ruffsl/ROBO/Documentation/Pictures/Design Photos/UnicyclePhoto3.JPG

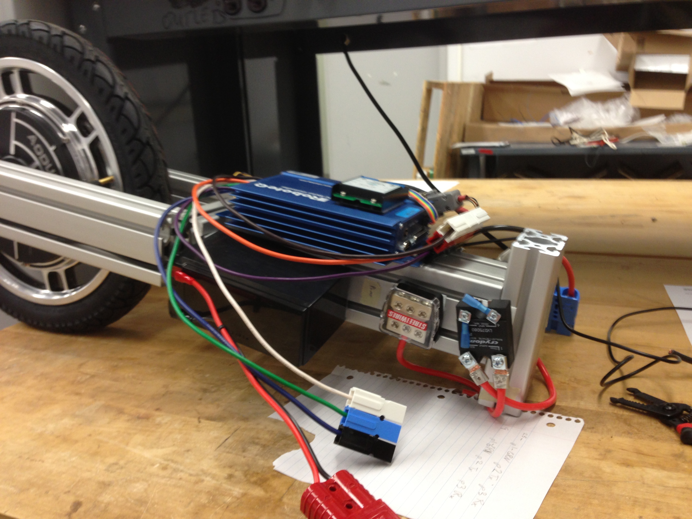
Documentation/Pictures/Design Photos/UnicyclePhoto3.JPG
