ruffsl/ROBO/Documentation/Pictures/Design Photos/UnicyclePhoto1.JPG

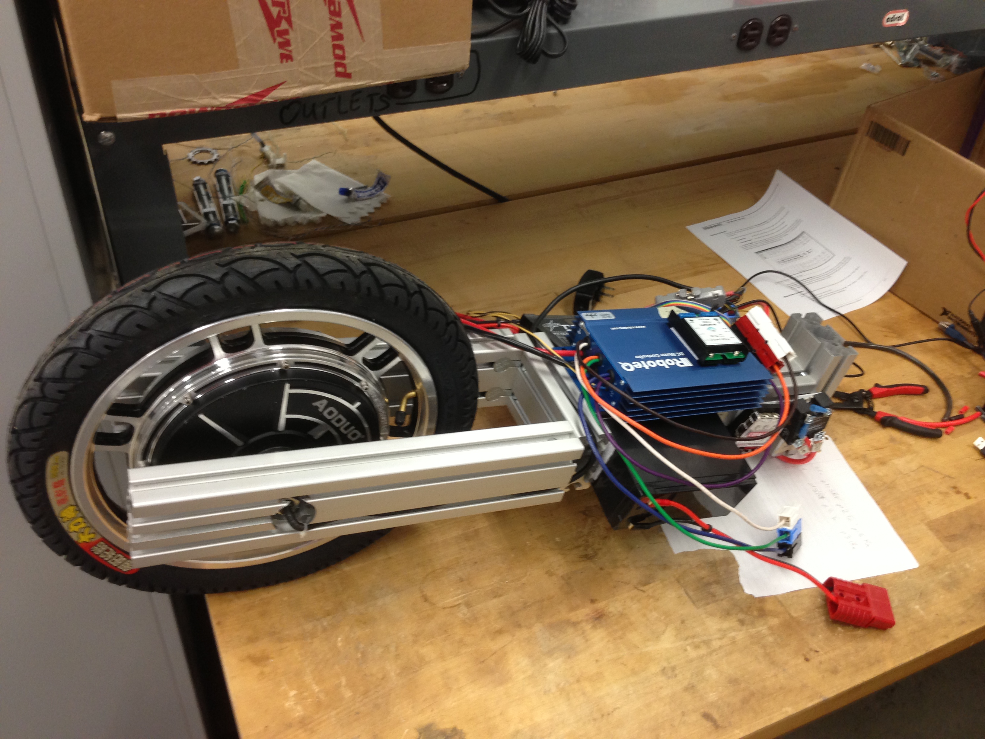
Documentation/Pictures/Design Photos/UnicyclePhoto1.JPG
