ruffsl/ROBO/Documentation/Power Points/Overview.pptx

## Slide 2

System Modeling
Part acquisition
Prototype Construction
Control Debugging
Documentation
Community Publication

## System Modeling Part acquisition

System and Model Research
Part listings and specking
Computer Simulation
System Characterization
Control Testing
Part Ordering and Inventory

## Prototype Construction Control Debugging

Sensor Feedback Development
Motor Control Hookup
Frame Construction
Transition to Mobile Power
Control deployment
System Testing

## Documentation Community Publication

Fine Tuning Overlap
Release Project Cleanup
Collect Resources
Tutorial and Instructions
Demonstration
Community Publication
