ruffsl/ROBO/Documentation/Power Points/Robotics Design.pptx

## Robotics Design Team G Robotic Unicycle

Spencer Carver, Ander Solorzano,
Kevin Collins, Ruffin White-Magner

## Parts


- Real-time Platform
  - NI cRIO
- Hub-motors
  - Golden Motors
- Motor Controllers
  - RoboteQ
- IMU
  - Microstrain
- Battery
  - Sealed Lead Acid

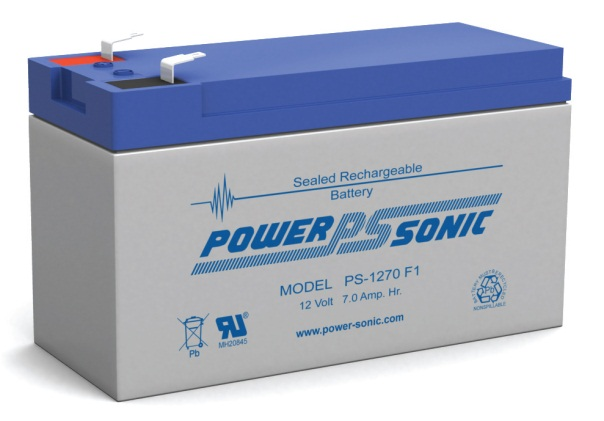
[picture p67: figure]

## Modeling

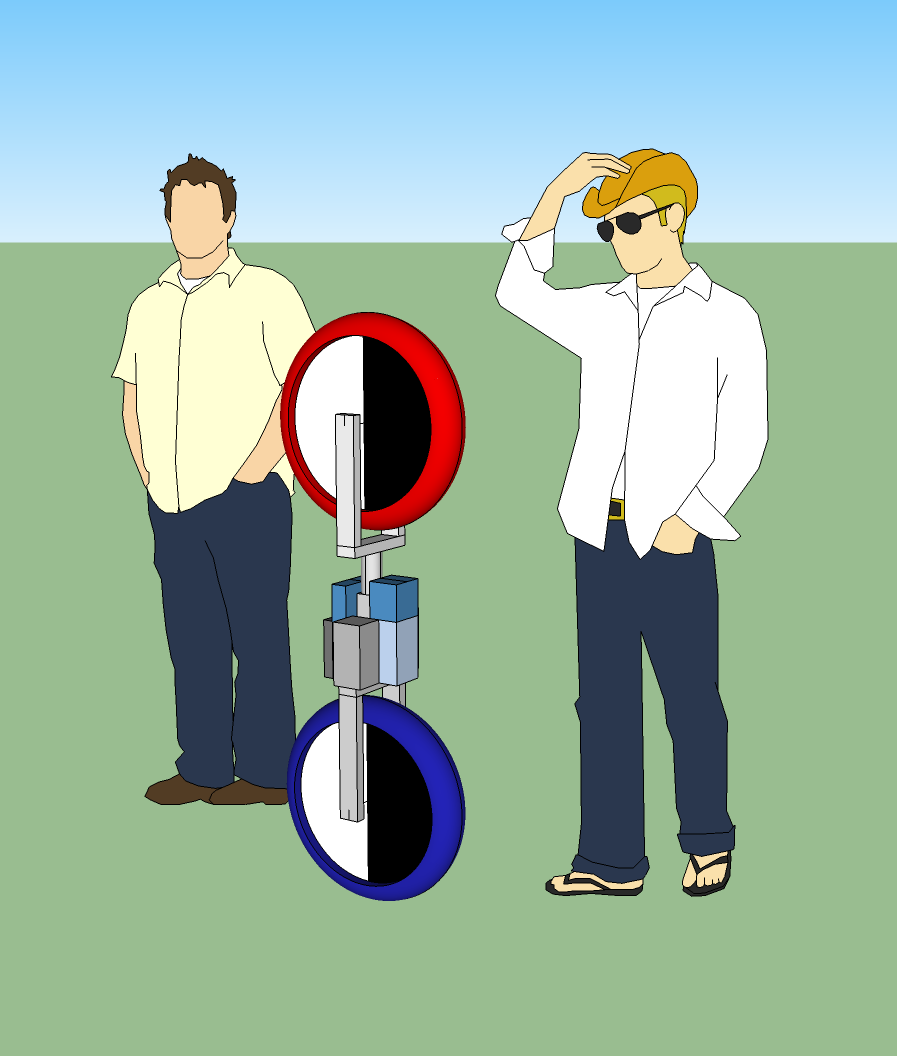
[picture p68: figure]
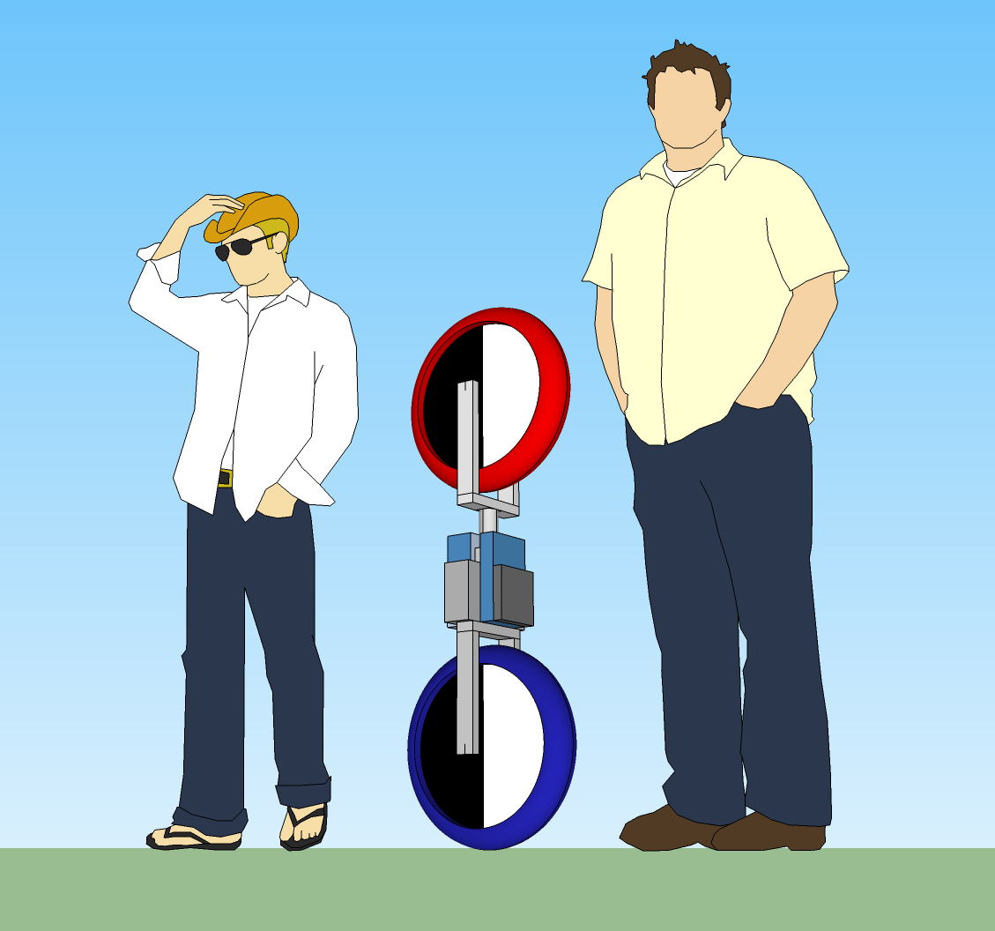
[picture p69: figure]

## Simulation

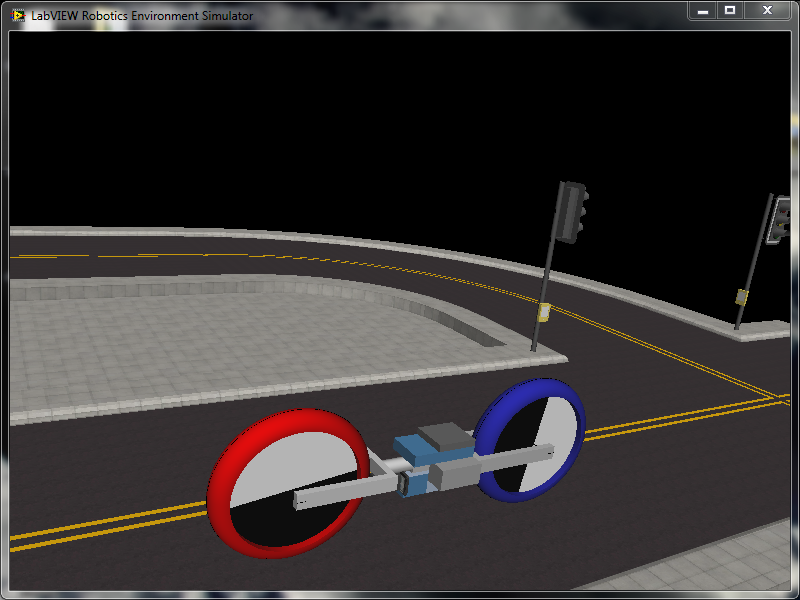
[picture p70: figure]
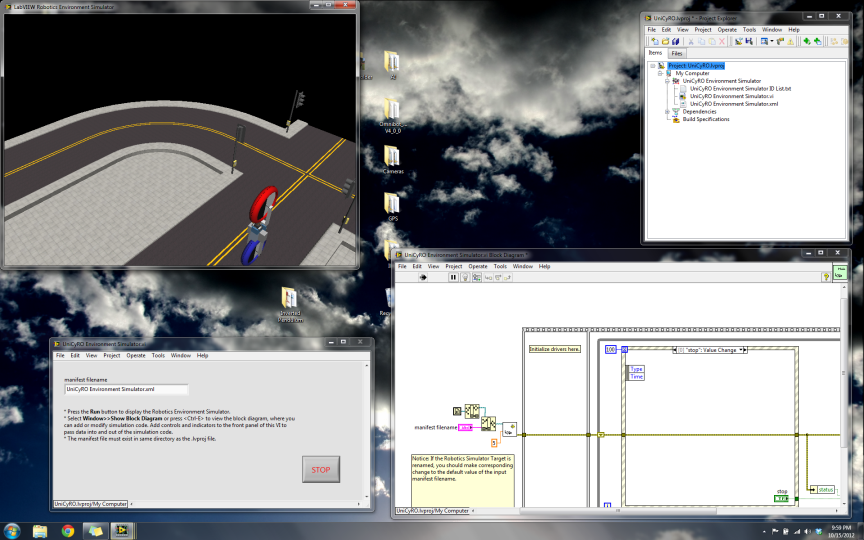
[picture p71: figure]
