ruffsl/ROBO/Documentation/Online Docs/Final Report - Spring Quarter/Action Plan.docx

Ruffin:

write timeline

NI student design submission

clean repo

Kevin:

wiring diagram

finish parameter spreadsheet

add stuff to repo

Ander:

start working on powerpoint - we’ll get together and finish up sunday night.

Spencer

decision matrices

testing plan

start exporting things to the binder

FSM overall “block diagram” (they say every project should have some sort of block diagram)
