ruffsl/ROBO/Documentation/Online Docs/Final Report - Spring Quarter/Final Presentation.pptx

## Self Balancing Unicycle

## Project Overview

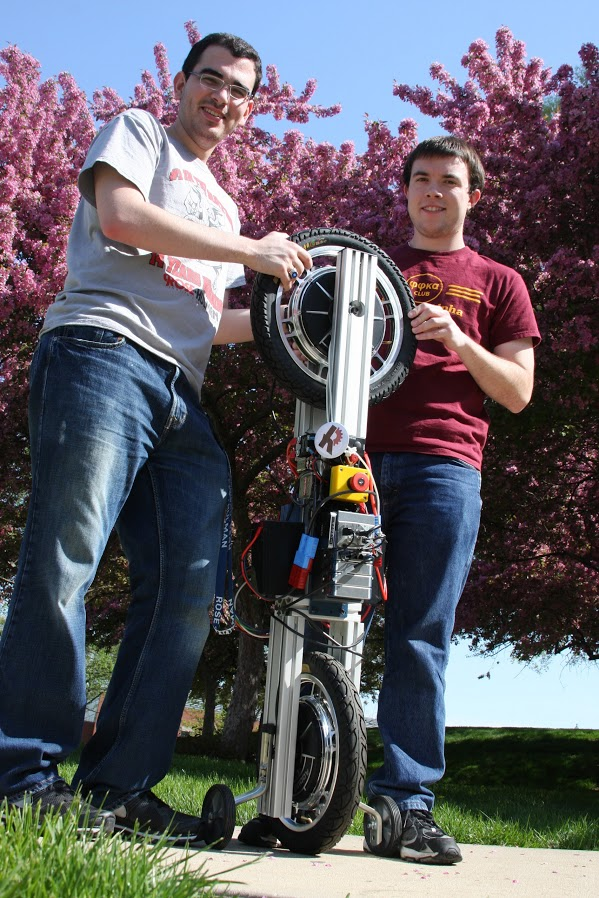
[picture p72: figure]

## System Description


## System Modeling

## Technical Specifications

pic of cRIO, motor controller

## Controls

## Unforeseen Challenges

## Testing Plan

## Suggestions for Improvement
