ruffsl/ROBO/Documentation/Power Points/Design Reviews/Speech Notes/Presentations/Final Presentation.pptx

## Self-Balancing Unicycle

Client: Andy Chang (National Instruments)
Supervisor: Dr. Robert Throne
Leader: Kevin Collins
Members: Spencer Carver
Ander Solorzano
Ruffin White-Magner

Team
G

Notes: Kevin

## Slide 2

Project Overview

Build a self-balancing robotic unicycle for National Instruments (NI), using NI components where possible


Notes: Kevin – 30 sec

We have been asked by national instruments to design and build a self balancing unicycle robot to showcase NI’s newest robotics toolkit.

National Instruments has developed a full solution to solving challenging controls problems with real time components, and this project is meant to show how a challenging controls problem can be solved using their components.

Our task is to develop a self balancing, autonomous unicycle style robot that can withstand disturbances such as light pushing. It does not have to navigate to a specific point or move at all, it only needs to balance independantly.

## Slide 3

Project Plan - Overview

Several Aspects to the Project:

Robotics Environment Simulator
Physical Construction
Mathematical Modeling
Electrical Wiring
Controls

Notes: Kevin – 30 sec

## Slide 4

Project Plan – Planning Flow Chart


Notes: Kevin – 30 seconds

Here you can see our project plan. The green line represents our current position in the plan, the checkboxes representing what has been accomplished. The fall has been and will continue to be primarily laying the groundwork for our project. We would like to have all of our components and make sure that we understand how they work and how to use them effectively. Then next quarter, we will be able to quickly and efficiently develop a control algorithm and build a physical model that will hopefully result in a working prototype by the end of the quarter. Then spring quarter is left entirely for debugging and final documentation.

## Slide 5

Project Construction - Mechanical


Notes: Kevin – 30 seconds

## Slide 6

Project Construction - Electrical

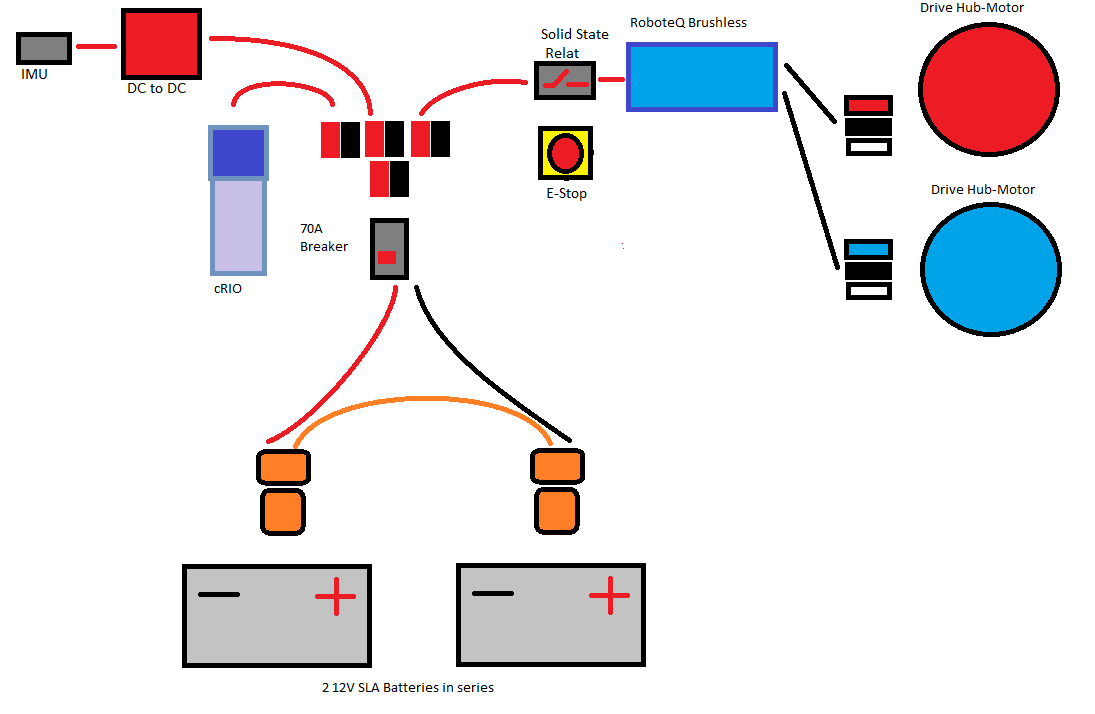
[picture p80: figure]

Notes: Ruffin – 30 sec
Labview Robotics Simulation Builder
With actuator and sensors
Build levels of complexity

## Slide 7

Project Software

Notes: Kevin

## Slide 8

Mathematical Modeling


Notes: Kevin – 30 seconds

## Slide 9

Control Strategies

Non-linear problem → Linearize → Use state variable description

Discrete time state variable feedback system


State Variable Equations

x(k+1)=G∗x(k)+H∗u(k)

y(k)=C∗x(k)+D∗u(k)

x(k) = state vector
u(k) = input vector to the plant
y(k) = output vector from the plant
G,H,C,D matrices are constant
K = feedback gain matrix

Notes: Ander – 2 min

## Slide 10

Control Strategies

Non-linear problem → Linearize → Use state variable description

Discrete time state variable feedback system

State Variable Equations

x(k+1)=G∗x(k)+H∗u(k)

y(k)=C∗x(k)+D∗u(k)

x(k) = state vector
u(k) = input vector to the plant
y(k) = output vector from the plant
G,H,C,D matrices are constant
K = feedback gain matrix

Notes: Ander – 2 min

## Slide 11

Control Strategies

Non-linear problem → Linearize → Use state variable description

Discrete time state variable feedback system

State Variable Equations

x(k+1)=G∗x(k)+H∗u(k)

y(k)=C∗x(k)+D∗u(k)

x(k) = state vector
u(k) = input vector to the plant
y(k) = output vector from the plant
G,H,C,D matrices are constant
K = feedback gain matrix

Notes: Ander – 2 min

## Slide 12

Project Status

Goal | Percent Complete
Simulation in LabVIEW | 100%
Physical Prototype Constructed | 100%
Balances in One Dimension | 75%
Balances in Two Dimensions | 20%
Controller Designed | 100%
Mathematical Model Designed | 100%

Notes: Kevin

## Slide 13

Project Status

Demo

Notes: Kevin

## Slide 14

Recommendations

- Moment of Inertia Calculations
- Improved Safety Rig

Notes: Kevin

## Slide 15

Conclusion - Questions

Budget

Simulator

Wiring Diagram

System Modeling

Hours

Notes: Kevin

## Slide 16

Simulation

Return

Return


Notes: Ruffin
Labview Robotics Simulation Builder
With actuator and sensors
Build levels of complexity

## Slide 17

Determining Parts – Budget

Total Cost: $27,740

Notes: Spencer

## Slide 18

Determining Parts – Budget

Total Cost: $4,740

Return

Notes: Spencer

## Slide 19

Wiring Diagram

Return


Notes: Kevin

## Slide 20

System Modeling

Return

State Variables

State Equations

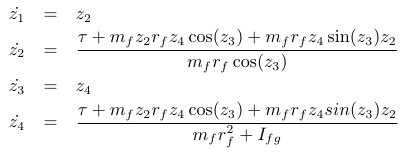
[picture p81: figure]
Screen Clipping

Notes: Kevin

## Slide 21

Hours

Total Team Hours - 784

Return

Notes: Kevin
