ruffsl/ROBO/Documentation/Design Documents/Ghant Chart - Sheet1.pdf

| | | | | | Fall Term | | | | | | | | | | Winter Term | | | | | | | | | | Spring Term
| | 1 | 2 | 3 | 4 | 5 | 6 | 7 | 8 | 9 | 10 | 1 | 2 | 3 | 4 | 5 | 6 | 7 | 8 | 9 | 10 | 1 | 2 | 3 | 4 | 5 | 6 | 7 | 8 | 9 | 10
Planning
Client Conference Calls
Project Planning
Install Software
Order Parts
Receive | Parts
Final Documentation
Modeling
Mechanical Modeling
Model Interaction with Sensors (software) Computer Programming & Simulation Assemble Mechanics
Assemble Electrical Hardware
Combine Components
Testing
Software Unit Testing
Integration Testing
Final Testing

# Ghant Chart
