ruffsl/ROBO/Documentation/Design Documents/Calculations/LaTeX/seniorDesignCalcs.pdf

# System Description and Modeling of a Self-Balancing Unicycle Robot

Kevin Collins
Rose-Hulman Institute of Technology Designed for National Instruments

May 12, 2013

1

## 1 Introduction

The purpose of this document is to provide a detailed explanation as to the derivation of the system model used for the self-balancing unicycle developed by Rose-Hulman’s Robotics Senior Design Team G for the client, National Instruments.

## 2 System Description

The Robot is composed of a chassis made of 40mm T-slotted aluminum extrusion. This type of frame works very well for our robot due to its modular nature. This means, however, that many of the parameters described in this document are non-static, in that it is very possible that they have changed. All of the calculations are as modular as possible so that any changes can be easily

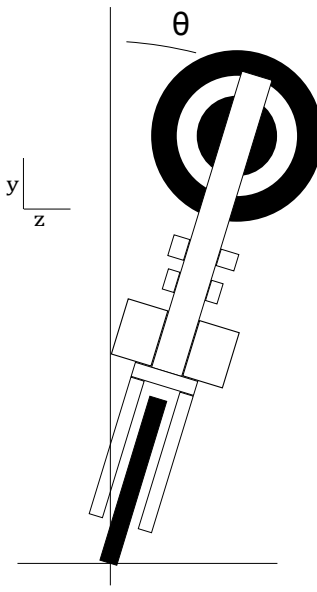
[picture p101: figure]
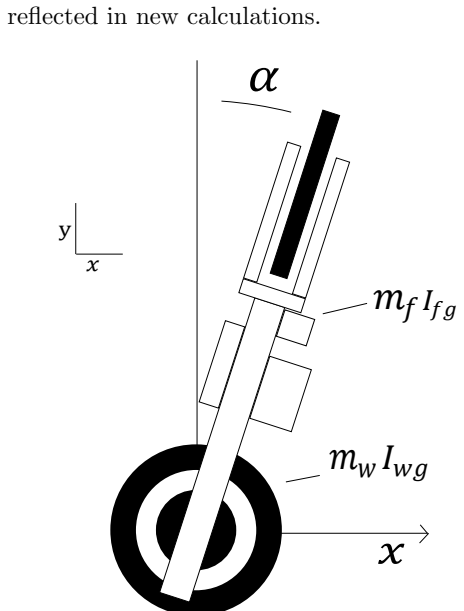
[picture p102: figure]
reflected in new calculations. 

Our robot must balance in two directions: about the z axis in the x-y plane, and about the x axis about the z-y plane. In both cases, the offset angle is measured from the inertial measurement unit located directly below the top wheel. In the first dimension (the x-y plane) the robot corrects itself by applying a torque to the lower wheel. In the second dimension (the z-y plane) the robot corrects itself by applying a torque to the upper wheel.

2

## 3 First Dimension

We start by looking at the general form of the Lagrangian equation. The Lagrangian is used in this application because of its modular nature compared to the conservation principle approach. If something with the model changes, the overall model can be easily updated.

L = T − V | (1)

In the Lagrangian, T is the kinetic energy associated with the system. The kinetic energy elements of our system include the rotational energy associated with the wheel spinning, the rotational energy associated with the frame spinning about the wheel, the translational energy associated with the wheel moving in the x direction, and the translational energy with the frame moving in the x direction relative to the movement of the wheel. These terms are shown below.

Translational energy, Wheel: 1
2

(mwx˙

2
)

Translational energy, Frame: 1 2mf ( ˙x

2 + 2 ˙xrfα˙ cos(α) + r

2
fα˙

2
)

Rotational energy, Wheel: 1
2
Iwgx˙

2
r

2
w

Rotational energy, Frame: 1
2

(If gα˙

2
)

The resulting expression for T is thus:

T =

1
2

(mwx˙

2

) + 1
2

mf ( ˙x

2 + 2 ˙xrfα˙ cos(α) +r

2
fα˙

2

) + 1
2
Iwgx˙

2
r

2
w
+

1
2

(If gα˙

2
) (2)

The V term in the Lagrangian equation is the potential energy of the system. In this case, this is simply the weight of the frame.

V = mf grf cos(α) | (3)

Combining the two terms to form the Lagrangian results in:

L =

1
2

(mwx˙

2

)+1
2

mf ( ˙x

2+2 ˙xrfα˙ cos(α)+r

2
fα˙

2

)+1
2
Iwgx˙

2
r

2
w
+

1
2

(If gα˙

2
)−mf grf cos(α)

(4)

The next step is to take the following derivatives and relate them to the virtual work of the system, in this case τ .

d

dt
∂L
∂α˙
−
∂L

∂α
= τ | (5)

3

The resulting derivative and its expanded form are shown below:

mf rf (¨x cos(α) − α˙ sin(α) ˙x) + mf r

2
fα¨ + If gα¨
− mfxr˙ fα˙ cos(α) = τ (6)

xm¨ f rf cos(α) − mf rfα˙ sin(α) ˙x + mf r

2
fα¨ + If gα¨ − mfxr˙ fα˙ cos(α) = τ (7)

This model is then put into state-space form, the state variables being:

z1 = x
z2 = ˙x
z3 = α
z4 = ˙α
(8)

The state model is then as follows:

z˙1 | = z2
z˙2 | =

τ + mf z2rf z4 cos(z3) + mf rf z4 sin(z3)z2 mf rf cos(z3)
z˙3 | = z4
z˙4 | =

τ + mf z2rf z4 cos(z3) + mf rf z4sin(z3)z2 mf r

2
f + If g
(9)

4

## 4 Second Dimension

The second dimension is calculated in a similar manner as the first. This time, T is computed from the rotation energy of the top wheel, the translational energy of the top wheel, the rotational energy of the frame, and the translational energy of the frame.

T =

1
2

mwx˙

2 +

1
2

If

˙θ
2 + τθ +

1
2

mf r

2
f

˙θ
2
(10)

V is then the gravitational potential energy of the frame, and the gravitational potential energy of the wheel.

V = mf gL1 cos(θ) + mwg(L1 + L2) cos(θ) | (11)

The Lagrangian is:
L = T − V | (12)

Which, when evaluated with the above equations, results in the following:

L =

1
2

mwx˙

2+

1
2

If

˙θ
2+τθ+

1
2

mf r

2
f

˙θ
2−mf gL1 cos(θ)−mwg(L1+L2) cos(θ) (13)

Taking the partial derivatives results in the following equations:

∂L
∂θ = mf gL1 cos(θ)mwg(L1 + L2) cos(θ) + τ | (14)

∂L
∂ ˙θ

= If

˙θ + mf r
2
f
˙θ | (15)

d

dt
∂L
∂ ˙θ
= If

¨θ + mf r
2
f
¨θ | (16)

d

dt
∂L
∂ ˙θ
−

∂L
∂ ˙θ

= If

¨θ + mf r
2
f

¨θ − mf gL1 cos(θ)mwg(L1 + L2) cos(θ) + τ (17)

which is equal to the virtual work of the system. This equation can then be put into state space form as shown in the first dimension.

5

## 5 Moment of Inertia Calculations

For our system, the moment of inertia was was calculated by combining the moment of inertia of the following elements:

- Top Components - top wheel, top fork, top junction
- Middle Components - IMU, e-stop power1, power2, dc-dc converter, relay, breaker, controller, battery1, battery2, cRIO, center column
- Lower Components - bottom wheel, bottom fork1, bottom fork2, bottom junction

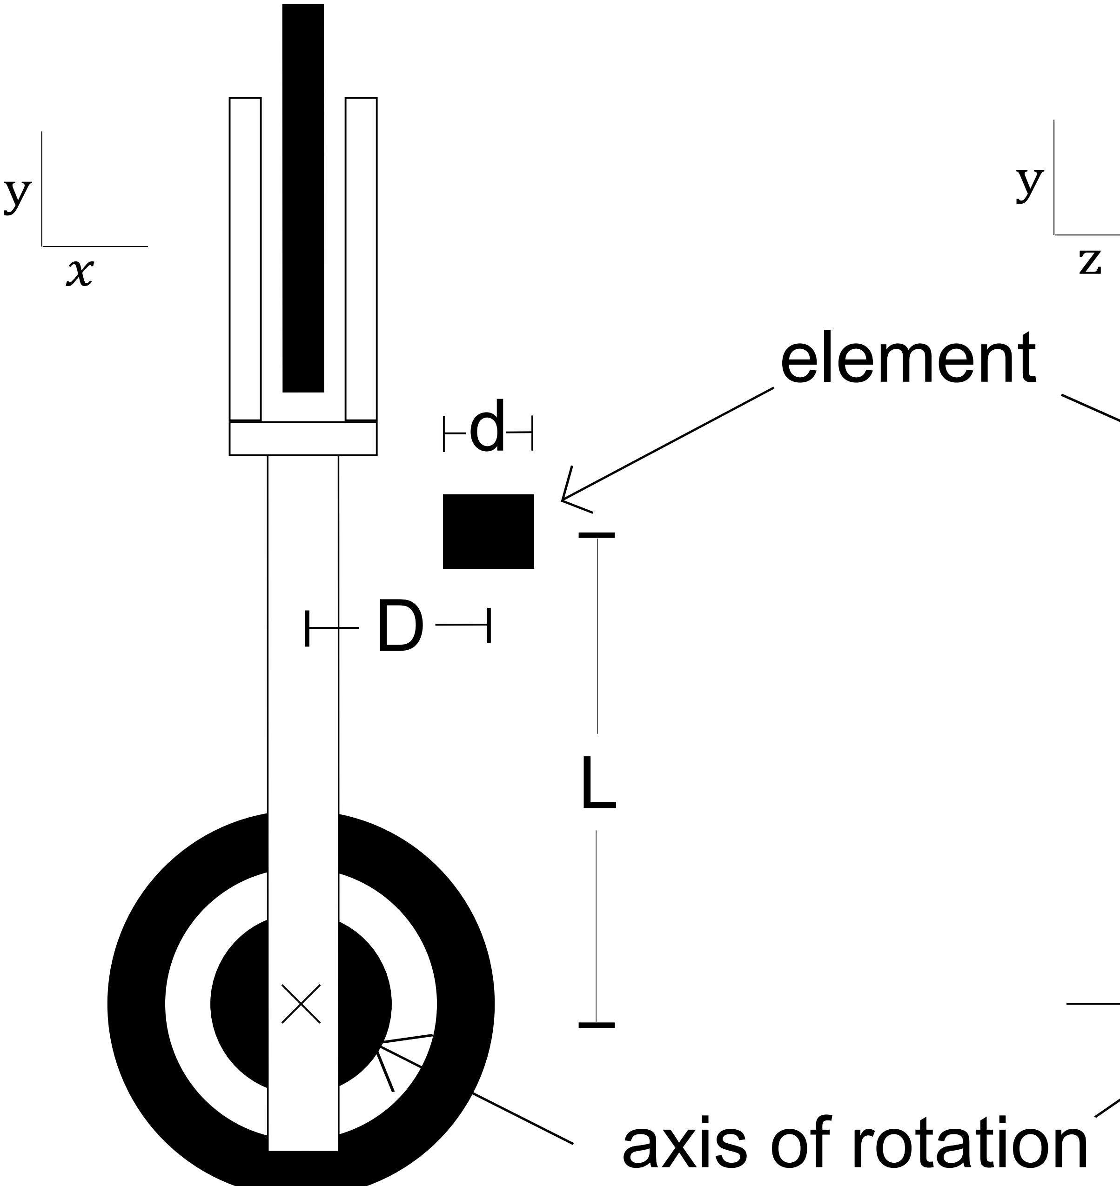
[picture p103: figure]
element; axis of rotation
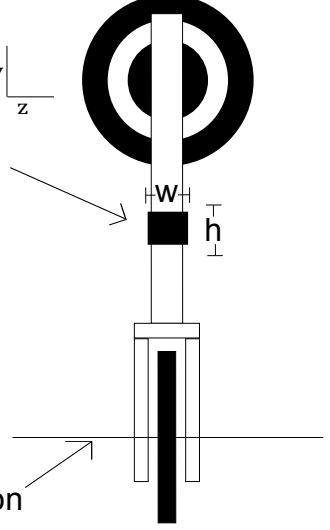
[picture p104: figure]

The equations for a moment of inertia of an object in 3d about an axis are represented by the following equations:

Ih =

1
12

m(w

2 + d

2
)

Iw =

1
12

m(h

2 + d

2
)

Id =

1
12

m(h

2 + w

2
)

(18)

In the system described in section 1, the first dimension has a rotation about the d axis. The equations above are valid if the elements are rotated about an axis that runs through the center of mass of the element. The axis of rotation

6

for most of our elements do not run through the center of mass, so to calculate this value, we use the parallel axis theorem. The parallel axis theorem can determine the moment of inertia about any axis given the moment of inertia about a parallel axis that passes through the center of gravity of the element, and the perpendicular distance between the two axes (r).

Iz = Icm + mr²
(19)

In the 3d case, r

2 has two vector components to it, resulting in an absolute distance from the axis of rotation. Many of our components are centered directly above the axis of rotation, so the third dimension is 0, but this is still accounted for in our calculation.

The rotation axis of the first dimension is about the axle of the lower motor. The rotation axis of the 2nd dimension is about the axis running along the length of the wheel where it contacts the ground.

All of the components on our robot were modeled as either rectangular prisms or solid cylinders.

For a solid rectangular prism, the equation for the moment of inertia about a given axis with

7

## 6 Suggestions for Improvement

As stated in the previous section, all of the components on our robot were modeled as either rectangular prisms or solid cylinders. This is an extreme simplification, especially in the case of the motors. If more work was to be done in modeling the system, I would suggest that a more accurate model of the wheels be determined first.

As far as the second dimension goes, these equations were not verified the same way that the first dimension was. The equations of motion were derived the same way they were for the first dimension, but they should be verified before deployed in a controller.

8
