ruffsl/ROBO/Documentation/Design Documents/bolts list.xlsx

 | in. | mm. | qty
relay | 0.19 | 4.826 | 2
power | 0.17 | 4.318 | 4
estop | 0.17 | 4.318 | 2
circuit breaker | 0.25 | 6.35 | 2
motor controller | 0.25 | 6.35 | 4
guard | 0 | 6 | 4
crio | - | 5.08 | 4
narrowest are 1.5 in away
