ruffsl/ROBO/Documentation/Design Documents/Calculations/values.xlsx

side rail (2 holes) | 1.624
side rail (4 holes) | 1.61
side rail chanel (4 holes) | 1.578
side rail chanel (2 holes) | 1.594
cRIO | 1.852
battery | 2.336
motor controller | 1.234
power splitter | 0.142
wheel | 7.645
imu | 0.024
center | 3.41 | 2.041
anchor bolts | 0.046
powerConverter | 0.104
relay switch | 0.124
muxer | 0.082
circuit breaker | 0.12
estop switch | 0.16
 | M | L | D | I
top wheel | 7.645
fork | 1.624
fork | 1.624
junction |  |  | #bolts | size
IMU | 0.024 |  | - | -
e-stop | 0.16 |  | 4 | 3
power | 0.142 |  | 2 | 3
power | 0.142 |  | 2 | 3
converter | 0.104 |  | - | -
relay | 0.124 |  | 2 | 3
breaker | 0.12 |  | 2 | 4
controller | 1.234 |  | 4 | 4
battery | 2.336 |  | - | -
battery | 2.336 |  | - | -
cRIO | 1.852
column |  |  | - | -
junction |  |  | - | -
fork | 1.624 |  | - | -
fork | 1.624 |  | - | -
bottom wheel | 7.645 |  | - | -
 | 25.467
Other dimension
 | M | L | D | I
top wheel | 7.645 | 92.6
fork | 1.624 | 85.3
fork | 1.624 | 85.3
junction |  | 63.3
IMU | 0.024 | 65.5
e-stop | 0.16 | 57.75
power | 0.142 | 54.5
power | 0.142 | 54.5
converter | 0.104 | 46
relay | 0.124 | 61.3
breaker | 0.12 | 60.5
controller | 1.234 | 42.345
battery | 2.336 | 38.8
battery | 2.336 | 38.8
cRIO | 1.852 | 40.35
column |  | 46.3
junction |  | 29.3
fork | 1.624 | 7.3
fork | 1.624 | 7.3
bottom wheel | 7.645
