ruffsl/ROBO/Documentation/Design Expo/Poster Draft.pptx

Mechanical Design

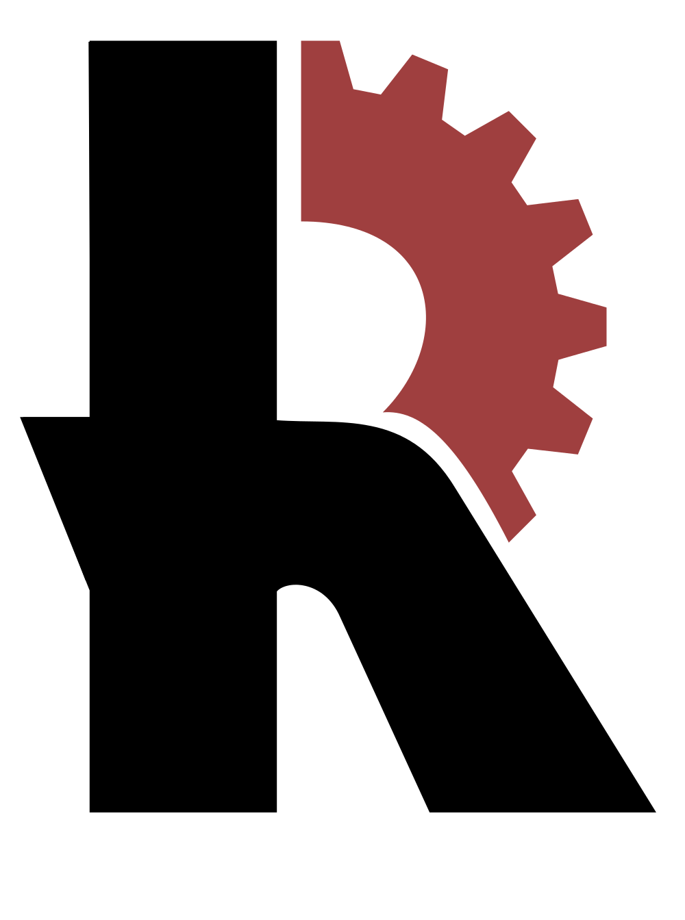
[picture p114: figure]

Simulation

Self Balancing Unicycle Robot

X-Y Direction

α

τ


Z-Y Direction

θ


τ

Anchor Bolts

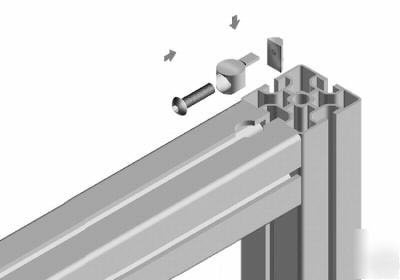
[picture p115: figure]

Problem Description:

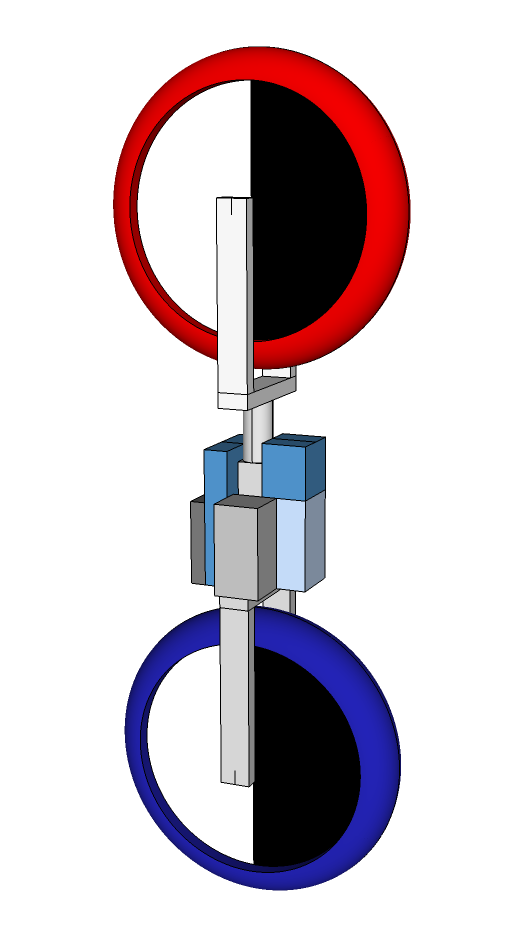
[picture p116: figure]

End Fasteners

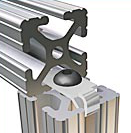
[picture p117: figure]

Unicycle Design

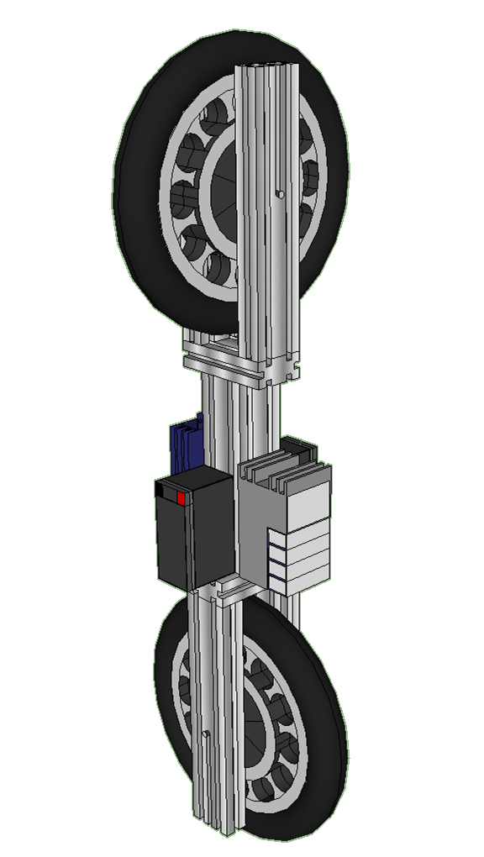
[picture p118: figure]

Control System Design

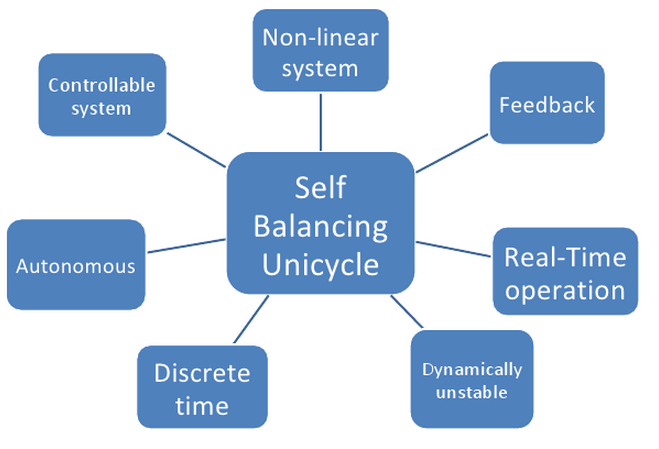
[picture p119: figure]

System Assembly

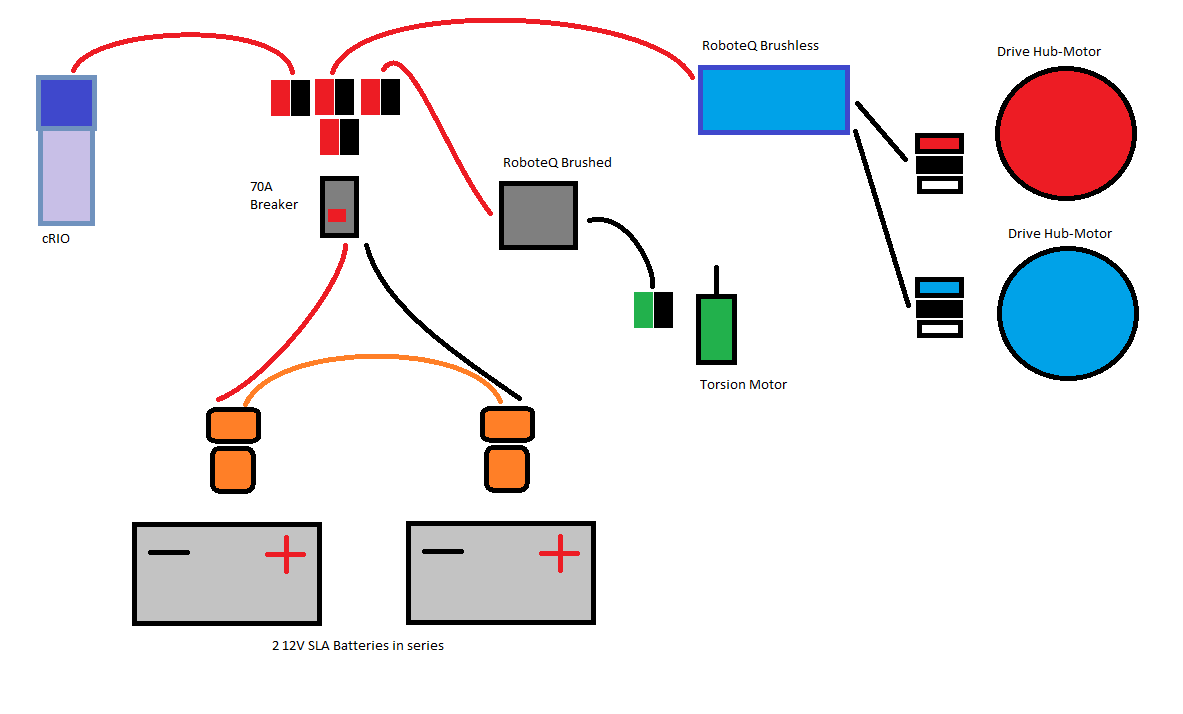
[picture p120: figure]

Team Members:
Kevin Collins
Spencer Carver
Ander Solorzano
Ruffin White-Magner

Client:
Andy Chang
(National Instruments)
Supervisor:
Dr. Robert Throne

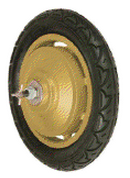
[picture p121: figure]
Omron Electronics Inc-EMC Div A22E-MK-02
