ruffsl/ROBO/Documentation/Online Docs/calculationsDocumentation.docx

T = total kinetic energy of the system

V = total potential energy of the system

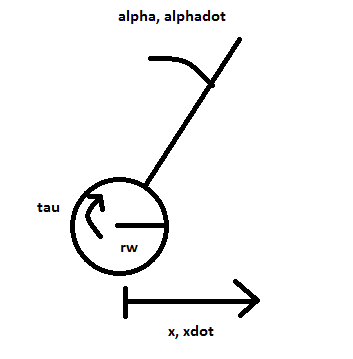
[picture p125: figure]
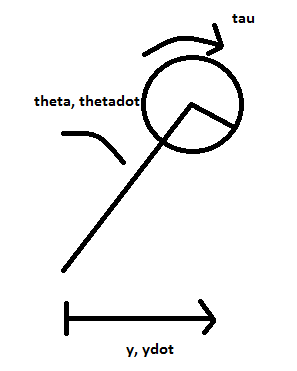
[picture p126: figure]
