ruffsl/ROBO/Documentation/Design Documents/Signed Scope of Work.pdf

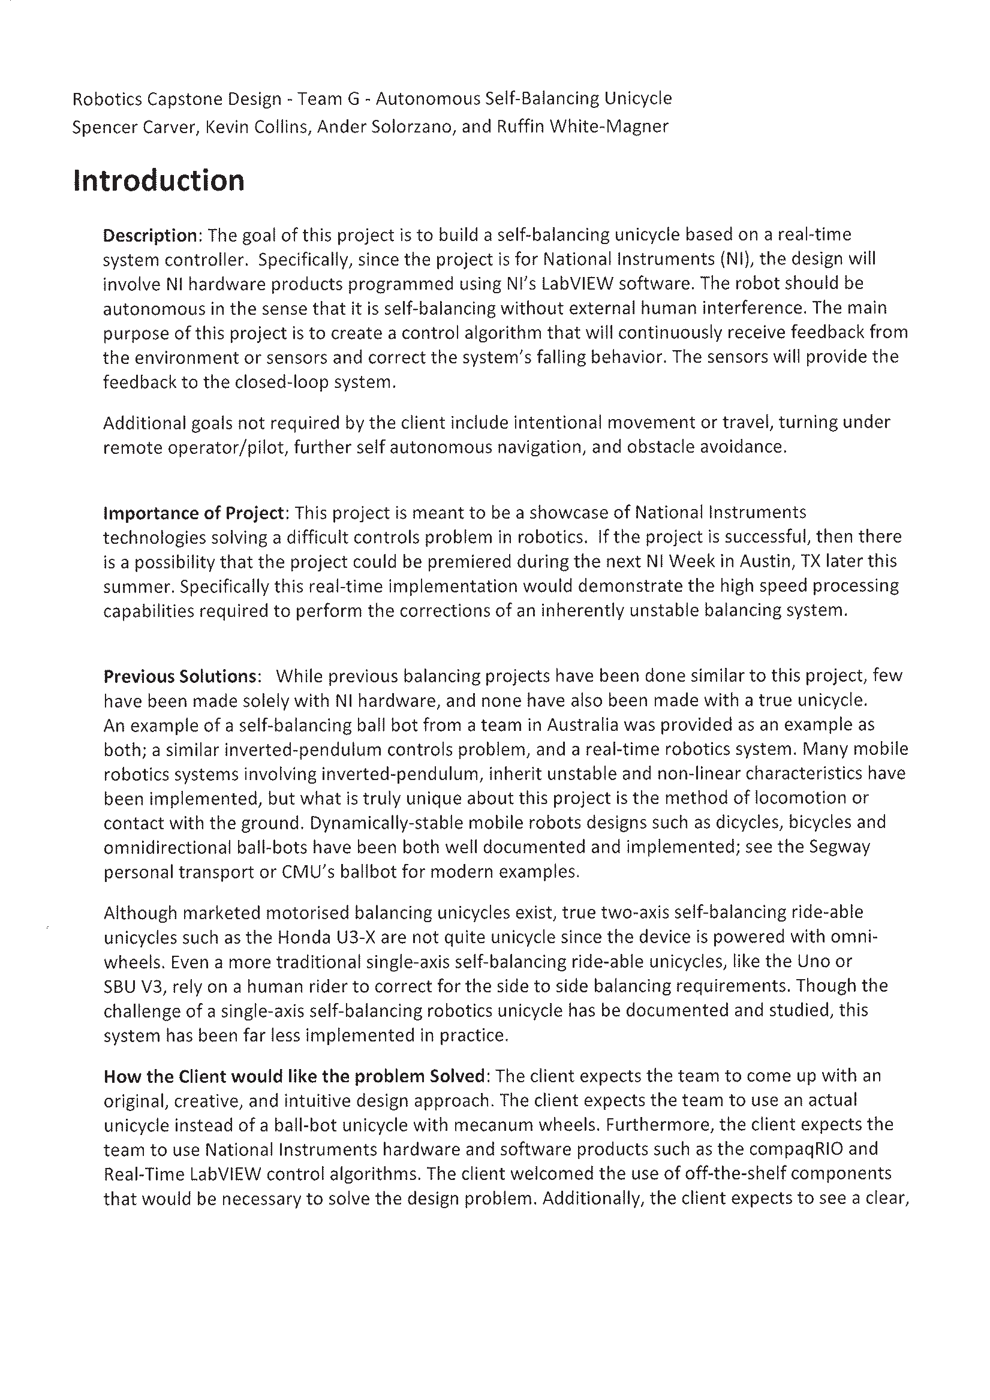
[picture p127: page 1]
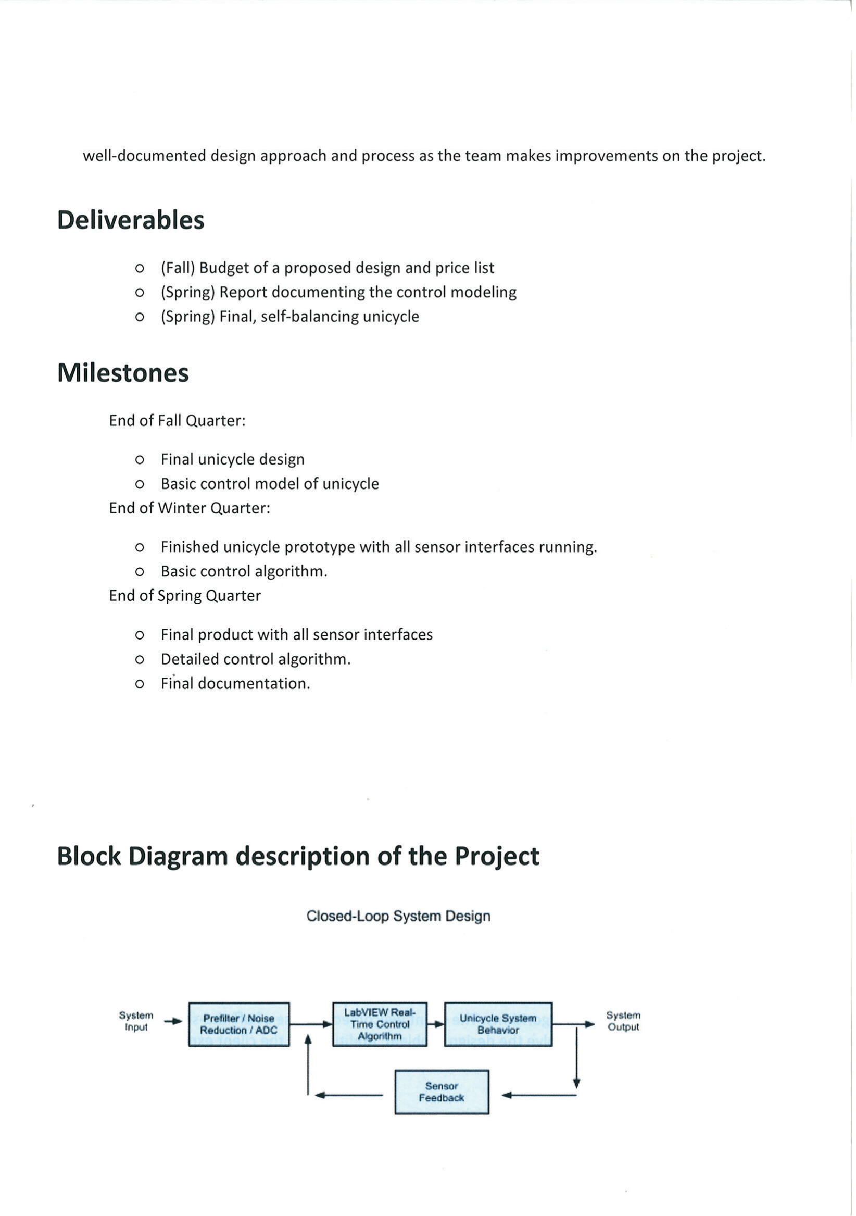
[picture p128: page 2]
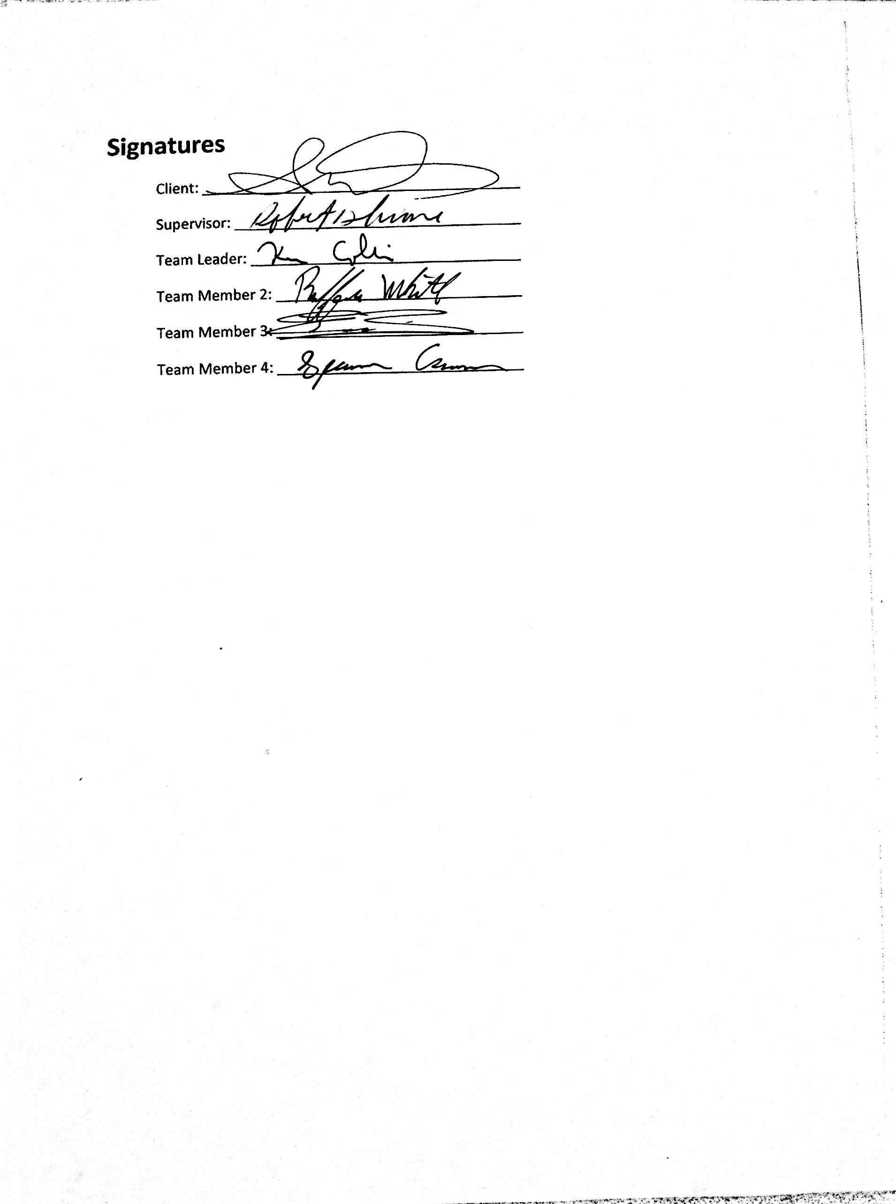
[picture p129: page 3]
