ruffsl/ROBO/Documentation/Design Documents/Calculations/LaTeX/momentOfInertiaDiagram-eps-converted-to.pdf

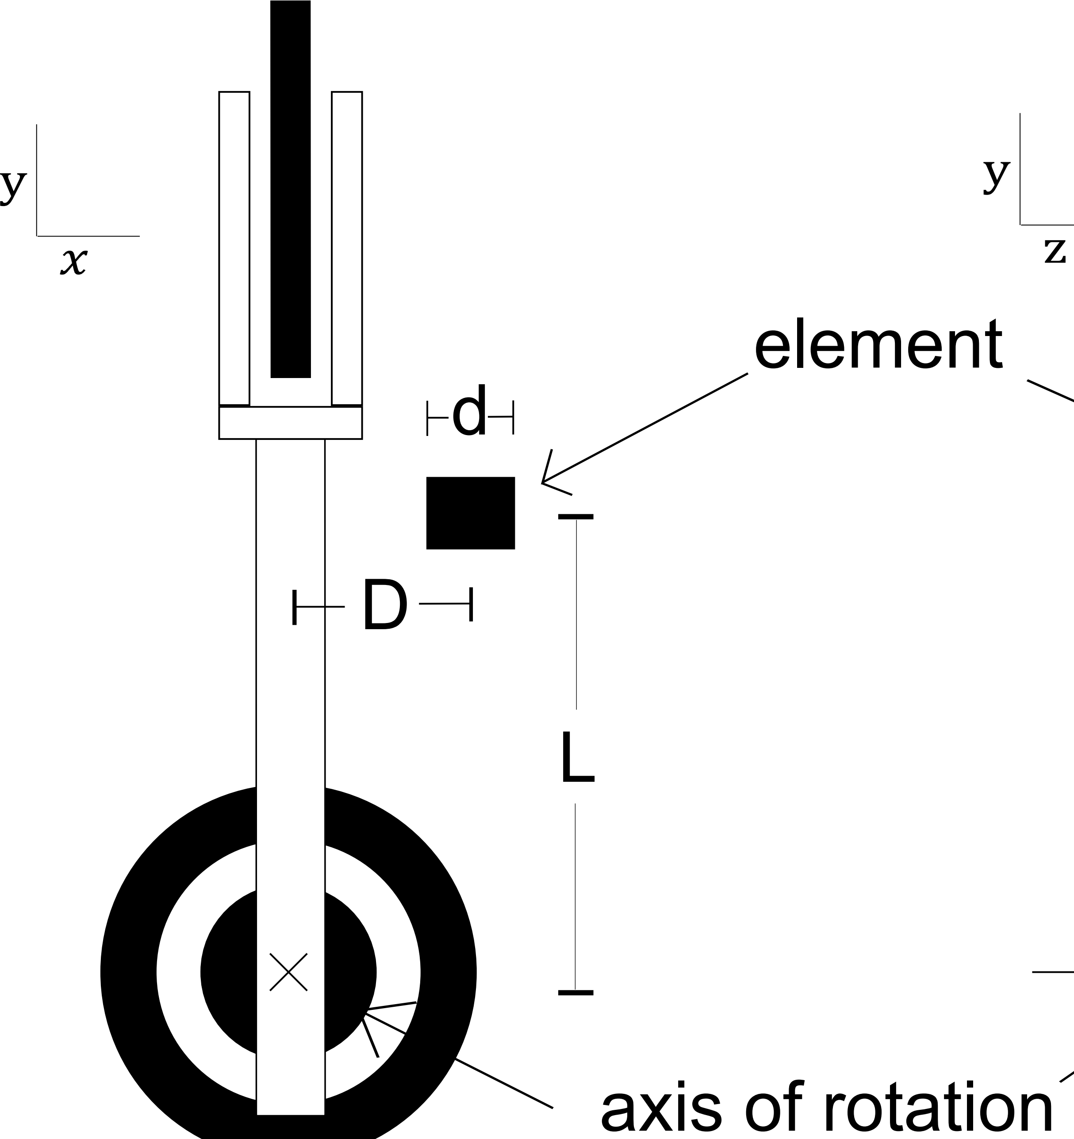
[picture p130: figure]
element; axis of rotation
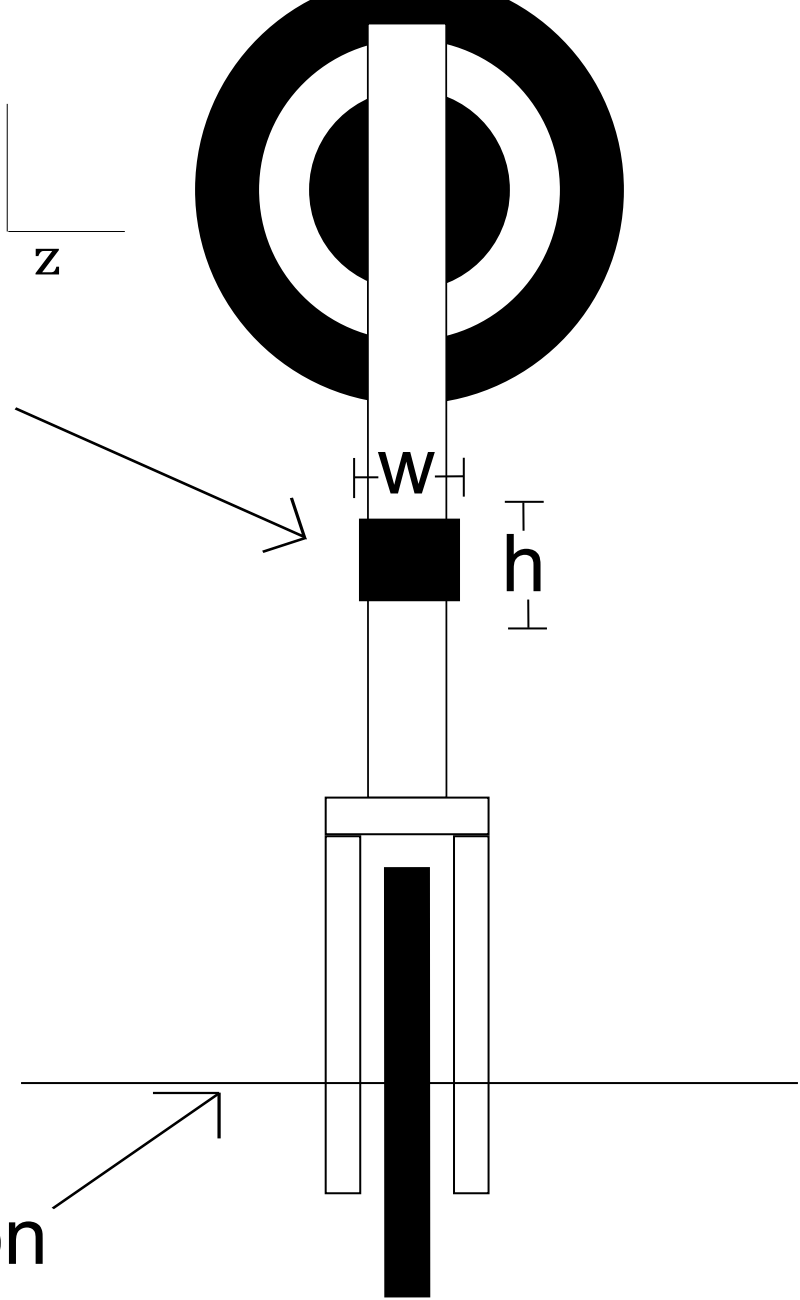
[picture p131: figure]
