ruffsl/ROBO/Documentation/Design Documents/Calculations/LaTeX/systemDescriptioinDiagram-eps-converted-to.pdf

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

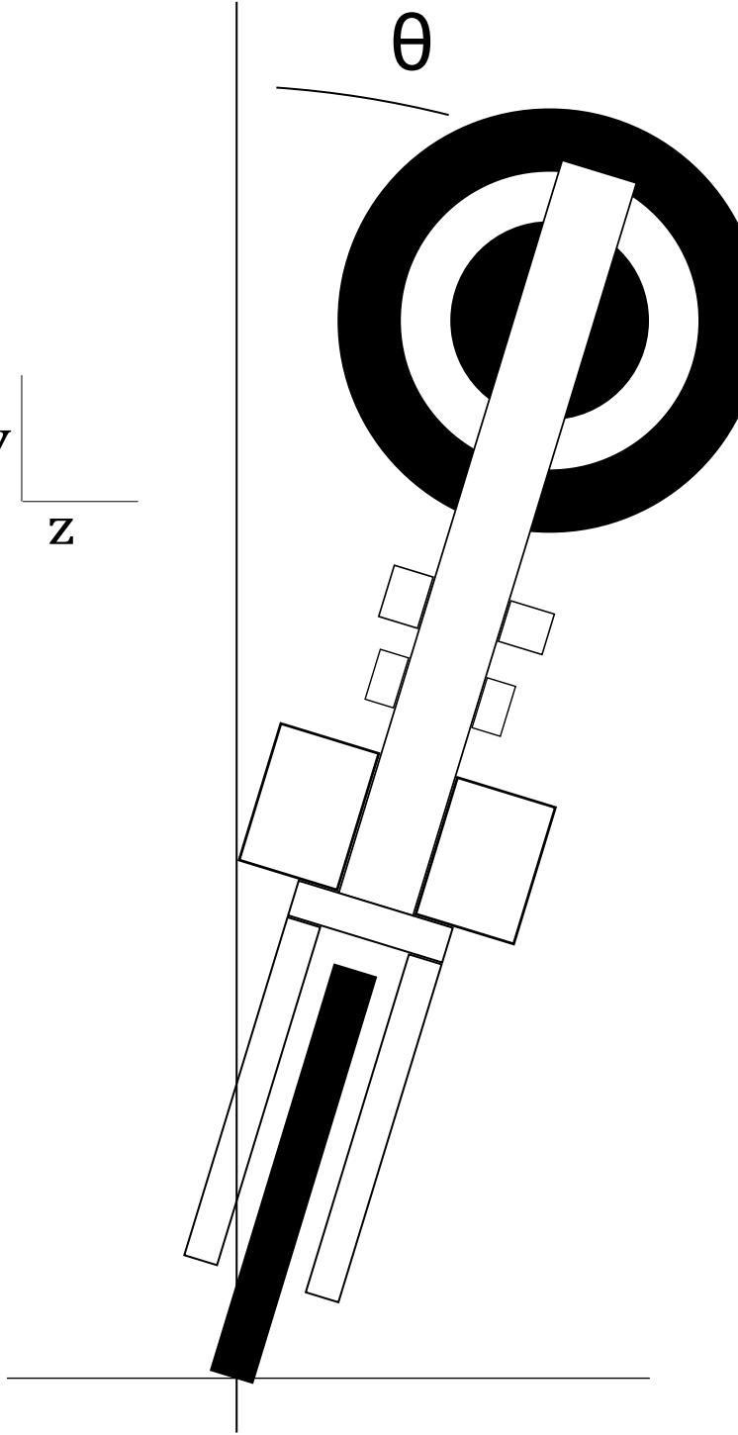
[picture p132: figure]
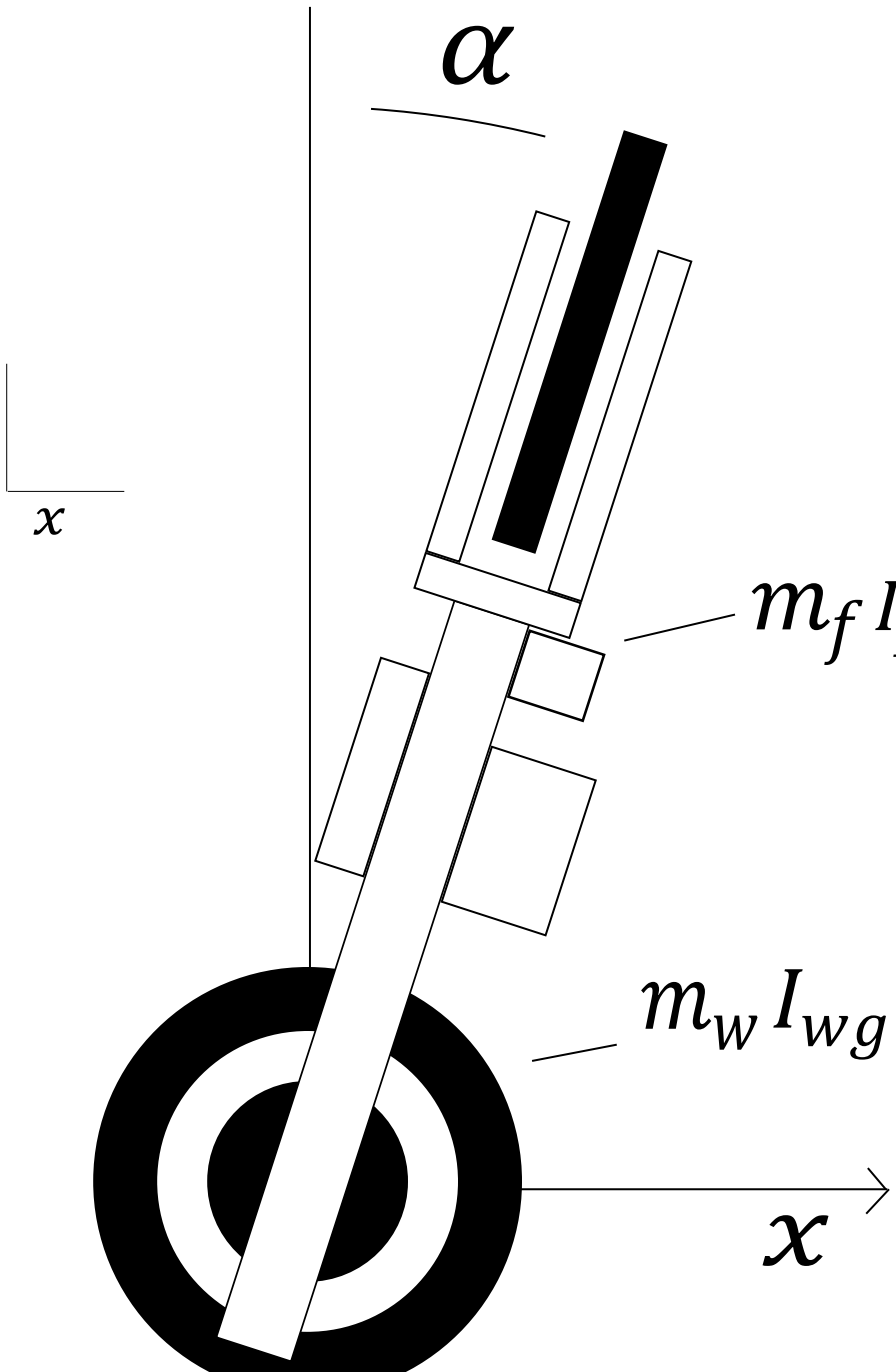
[picture p133: figure]
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
