ruffsl/ROBO/Code/Control Systems/Non-linear/robot Model Description.png

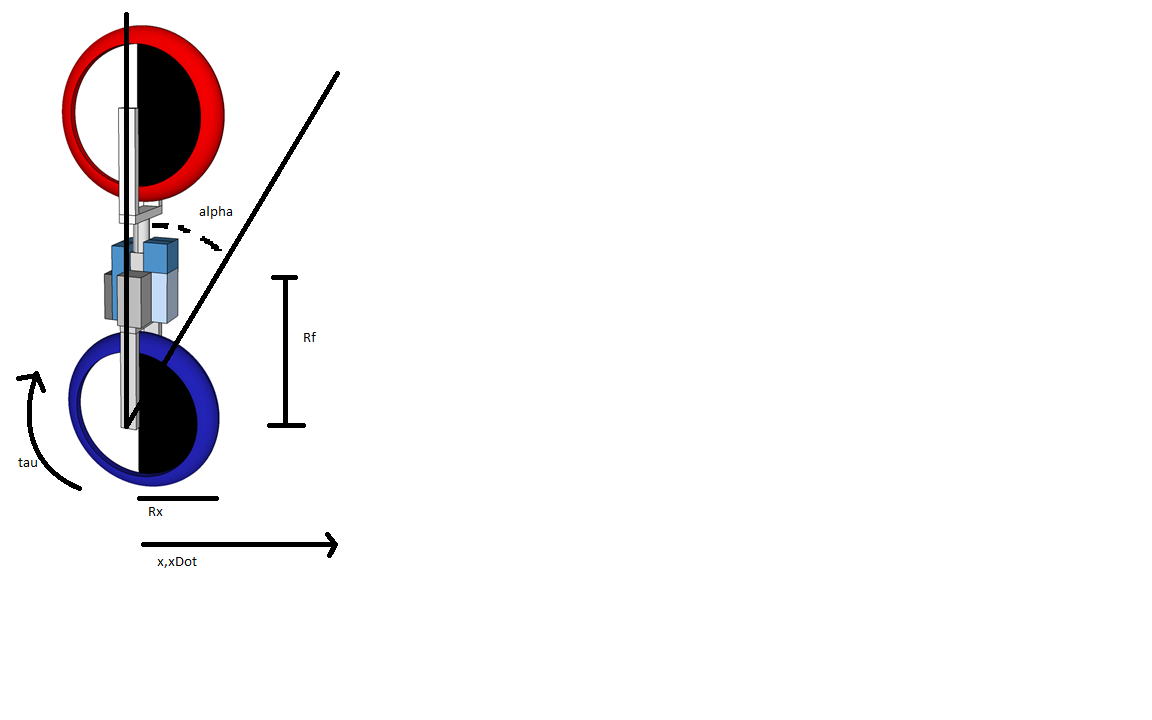
Code/Control Systems/Non-linear/robot Model Description.png
