ruffsl/ROBO/Devices/MicroStrain/IMU 3DM-GX3-45.jpg

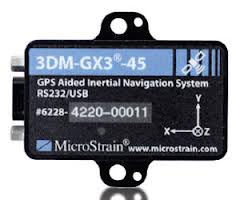
Devices/MicroStrain/IMU 3DM-GX3-45.jpg
