ruffsl/ROBO/Devices/Parts/Electronics/DC to DC/PTK25-D24-S15-T.JPG

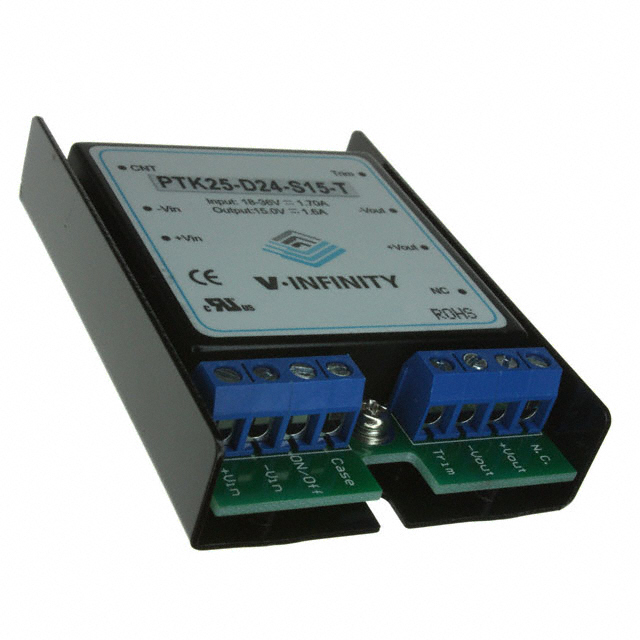
Devices/Parts/Electronics/DC to DC/PTK25-D24-S15-T.JPG
