ruffsl/ROBO/Documentation/Design Documents/Drawings/16寸.jpg

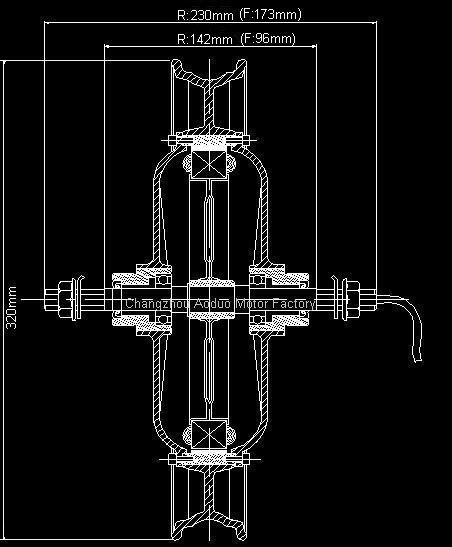
Documentation/Design Documents/Drawings/16寸.jpg
