ruffsl/ROBO/Documentation/Design Expo/Pics/End-Fastener-1.jpg

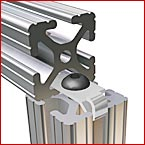
Documentation/Design Expo/Pics/End-Fastener-1.jpg
