ruffsl/ROBO/Documentation/Design Expo/Pics/frame dimensions.bmp

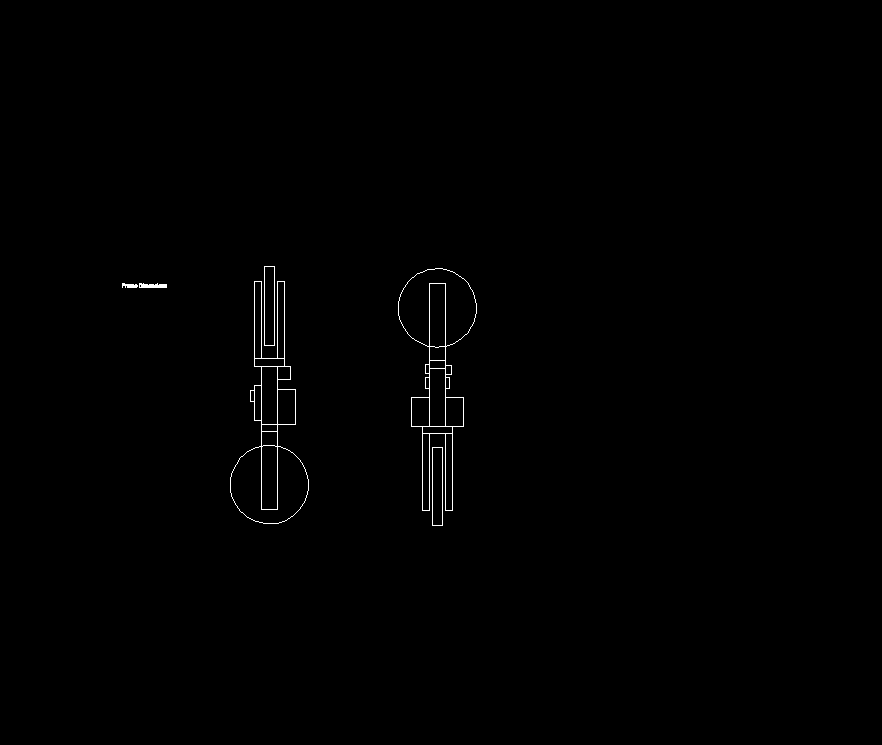
Documentation/Design Expo/Pics/frame dimensions.bmp
