ruffsl/ROBO/Documentation/Design Expo/Pics/me drawing.png

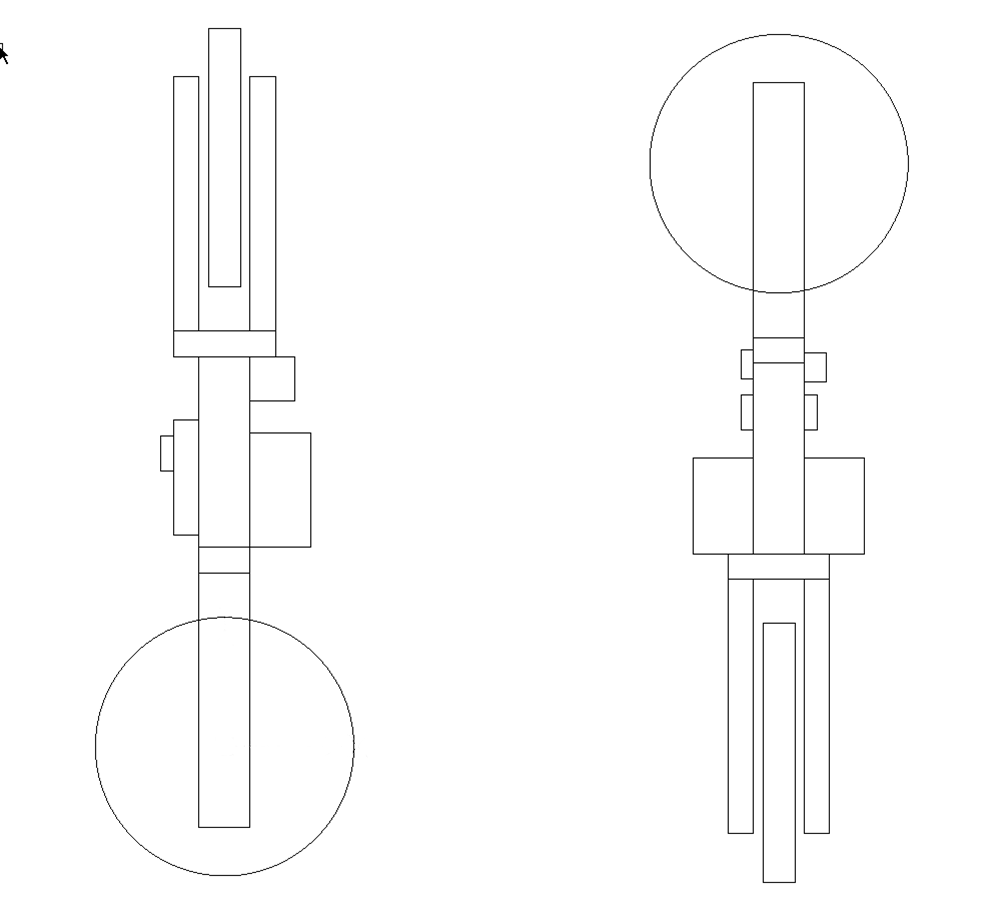
Documentation/Design Expo/Pics/me drawing.png
