ruffsl/ROBO/Documentation/Pictures/Circuit Diagram.png

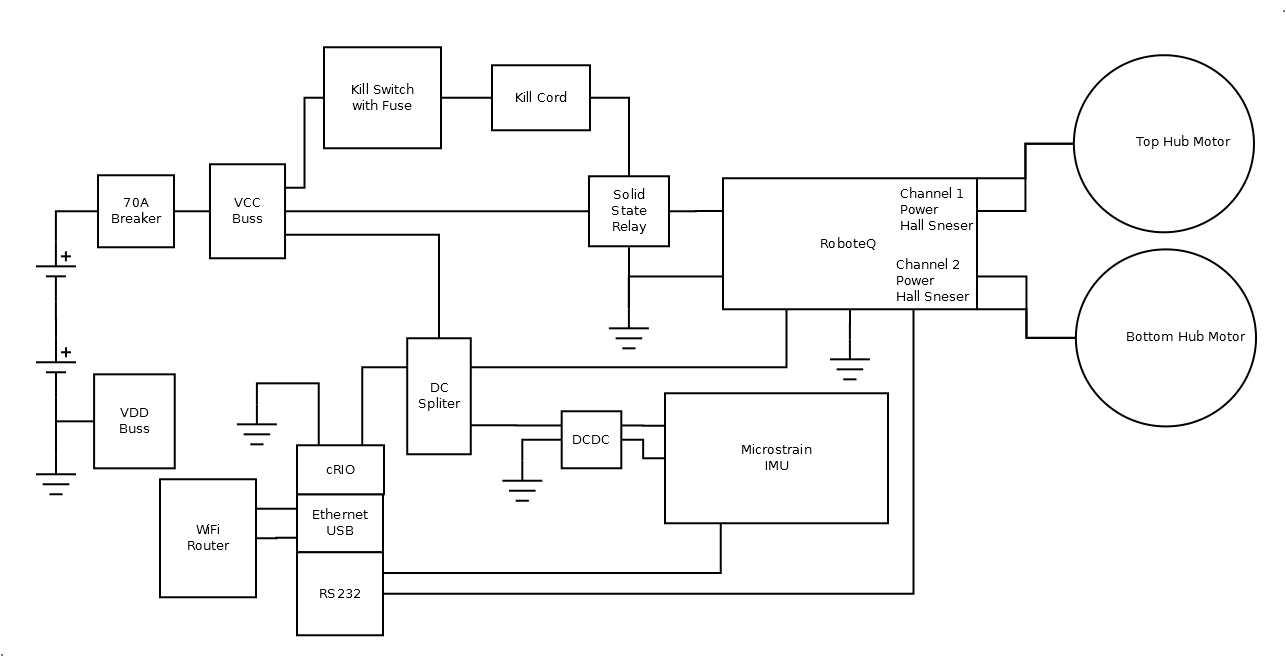
Documentation/Pictures/Circuit Diagram.png
