ruffsl/ROBO/Documentation/Pictures/comic 5.png

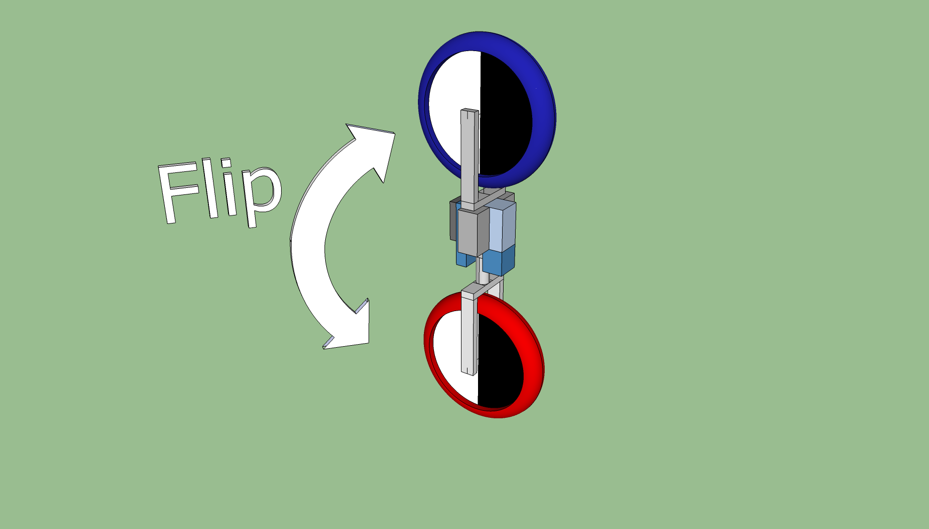
Documentation/Pictures/comic 5.png
