ruffsl/ROBO/Documentation/Pictures/Design Photos/UnicyclePhoto2.JPG

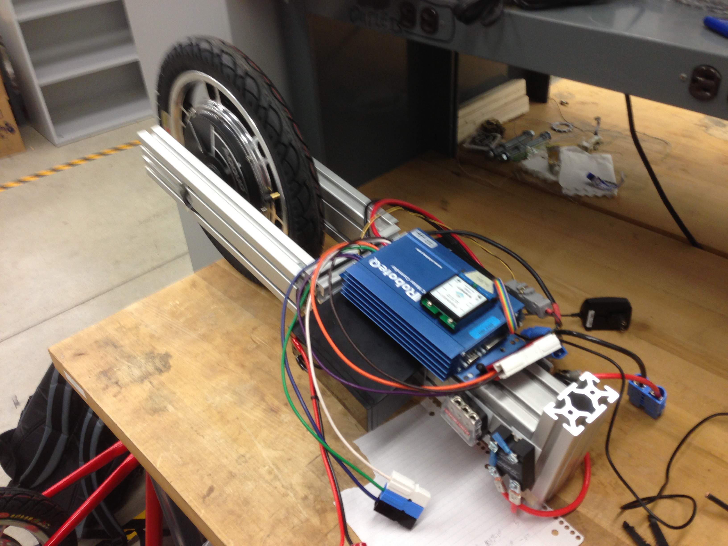
Documentation/Pictures/Design Photos/UnicyclePhoto2.JPG
