ruffsl/ROBO/Documentation/Pictures/Sim Model 3 white.png

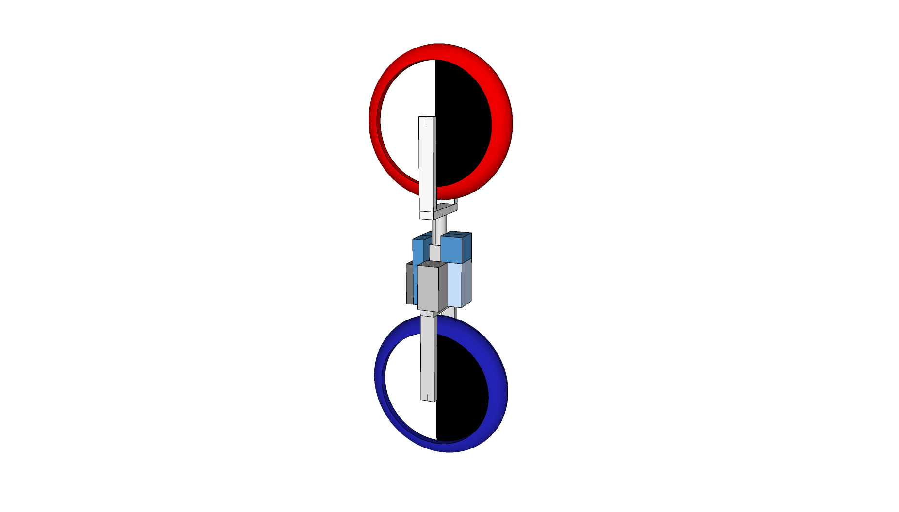
Documentation/Pictures/Sim Model 3 white.png
