ruffsl/ROBO/Documentation/Pictures/Sim Model 3.1.png

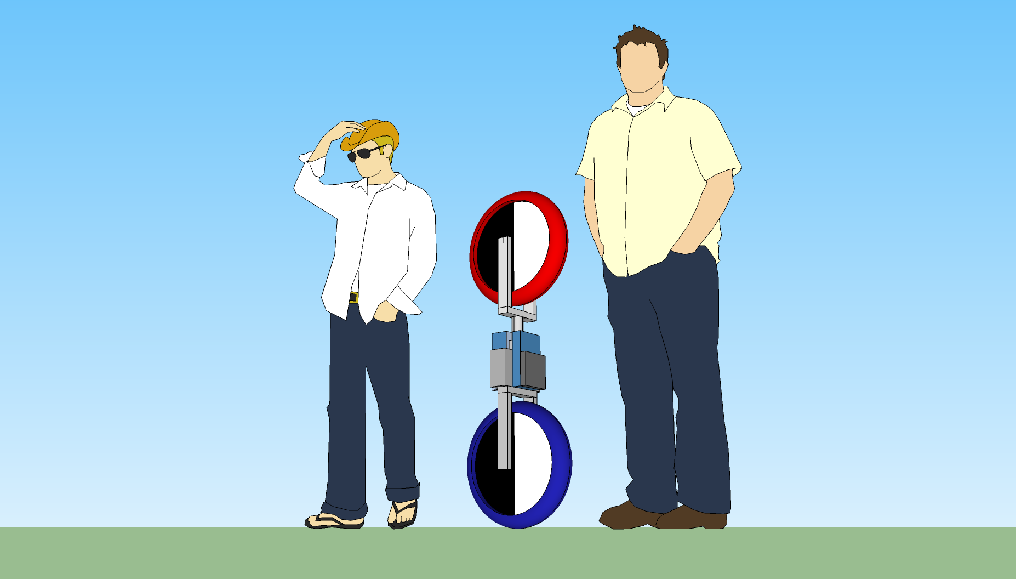
Documentation/Pictures/Sim Model 3.1.png
