ruffsl/ROBO/Documentation/Pictures/Sim Model 3.2.png

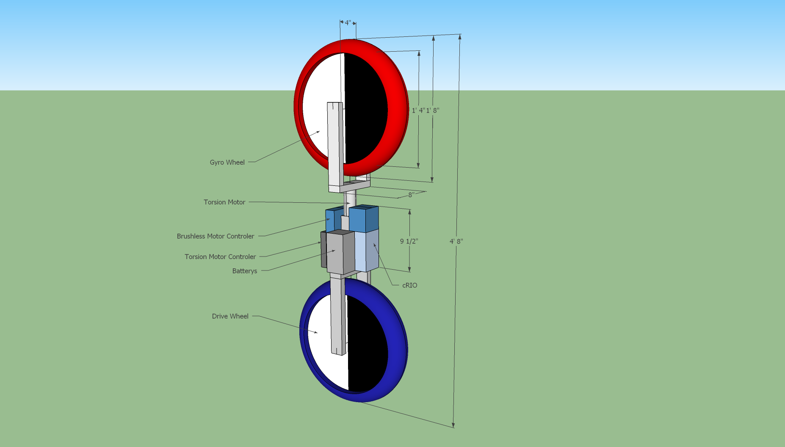
Documentation/Pictures/Sim Model 3.2.png
