ruffsl/ROBO/Documentation/Pictures/Sim Model 3.4.png

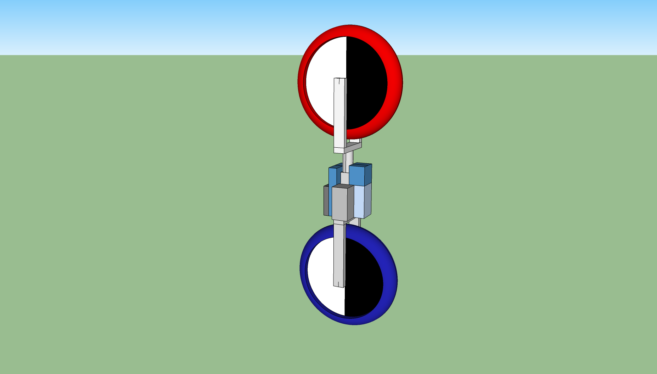
Documentation/Pictures/Sim Model 3.4.png
