ruffsl/ROBO/Documentation/Pictures/Sim Model 3.5.png

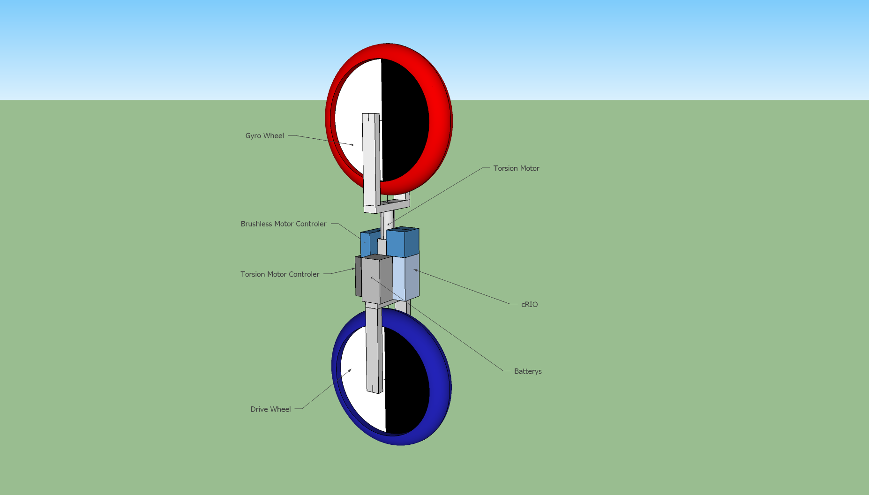
Documentation/Pictures/Sim Model 3.5.png
