ruffsl/ROBO/Documentation/Pictures/Sim Model 3.png

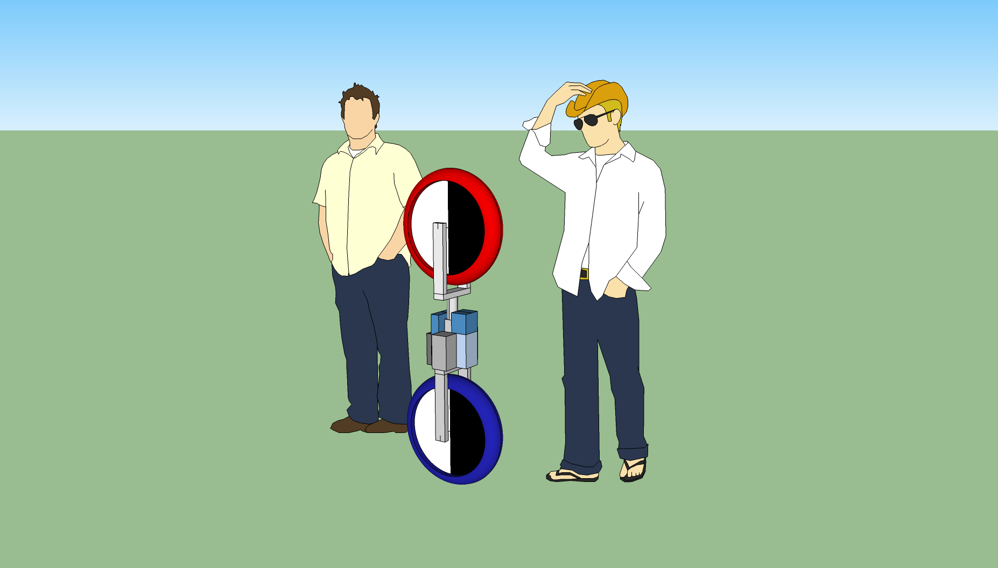
Documentation/Pictures/Sim Model 3.png
