ruffsl/ROBO/Documentation/Parts/Hradware/80_20 Parts Info.docx

Questions to ask 80/20 (the company we are buying it from)

Price Differences between light/regular and what the increased load would be?

Need bolts, nuts, end caps

Do you have any recommendations for a bracket that attaches to the wheel?

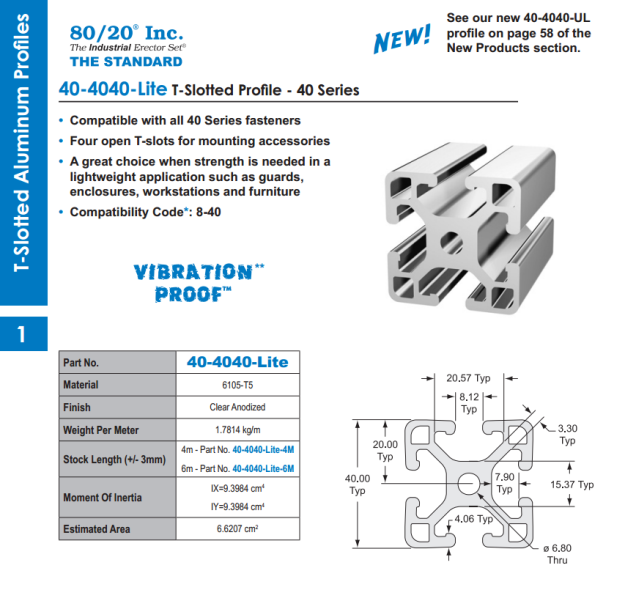
[picture p151: figure]
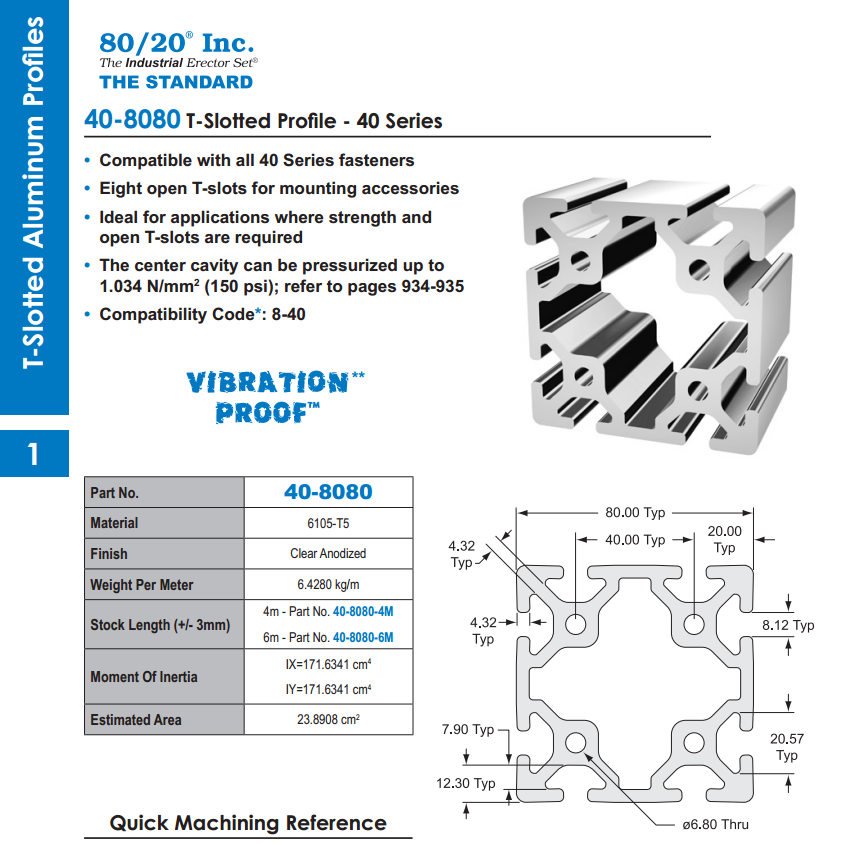
[picture p152: figure]
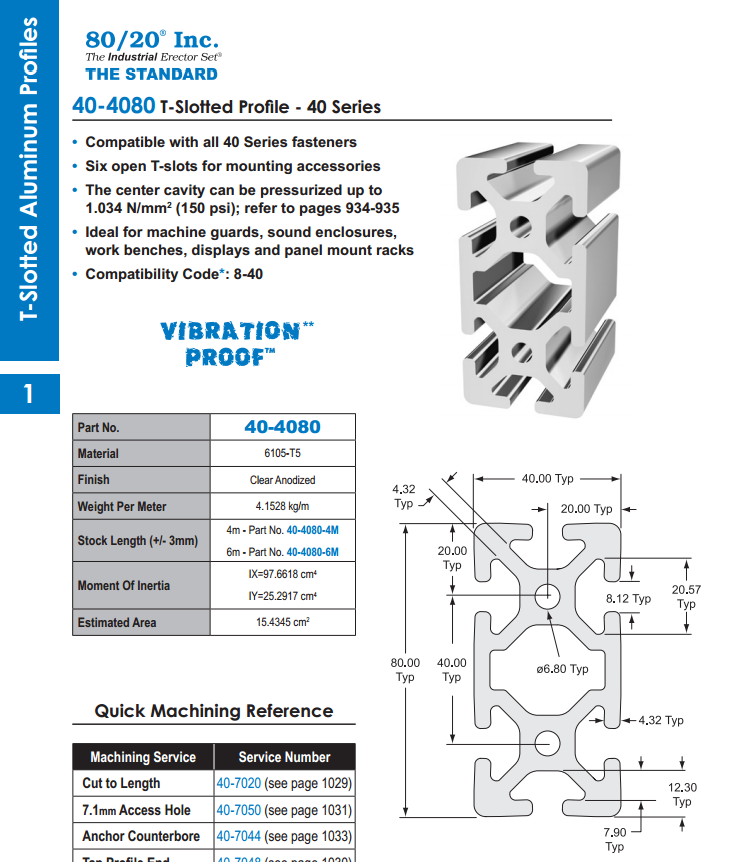
[picture p153: figure]
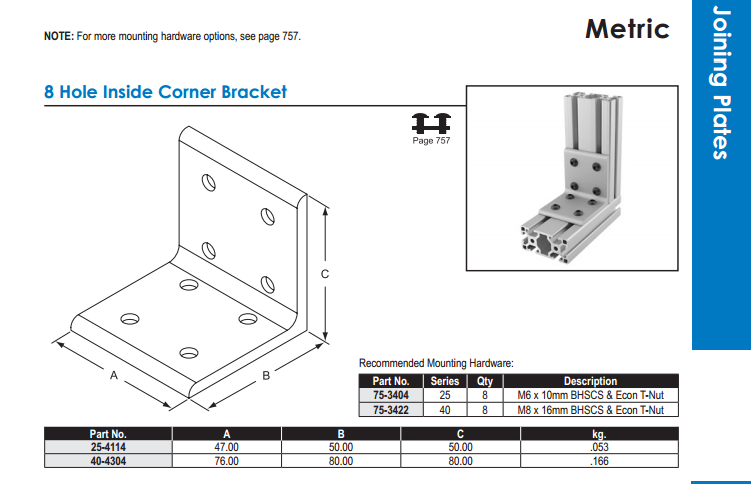
[picture p154: figure]
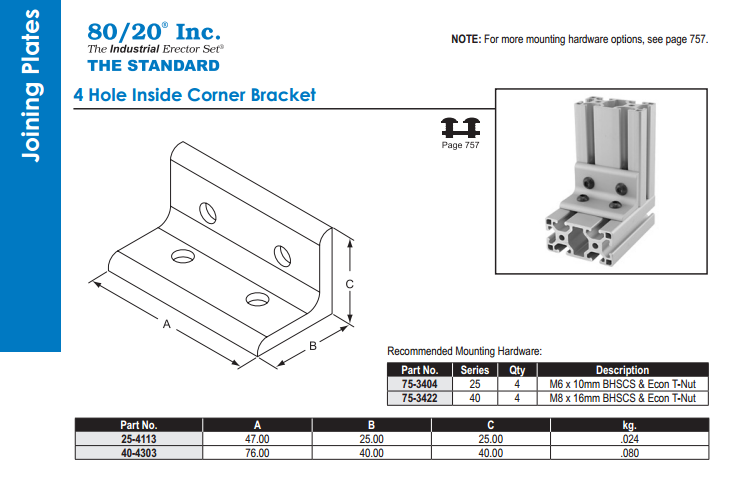
[picture p155: figure]
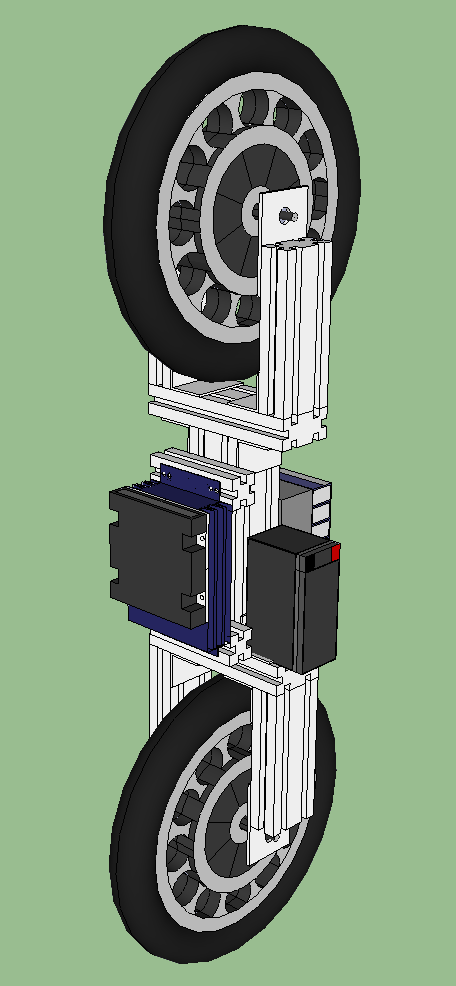
[picture p156: figure]
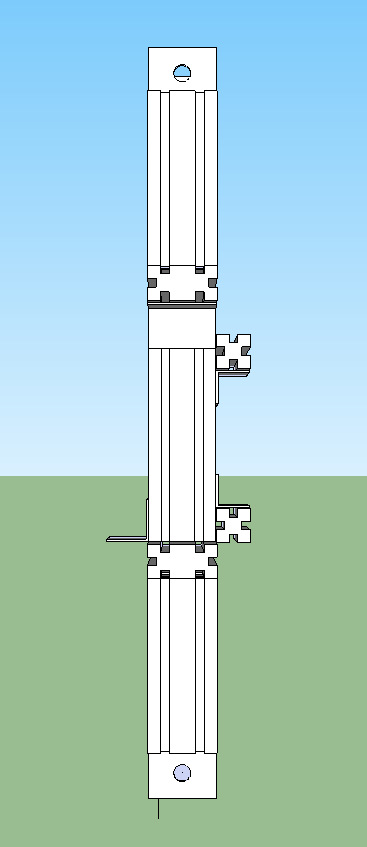
[picture p157: figure]
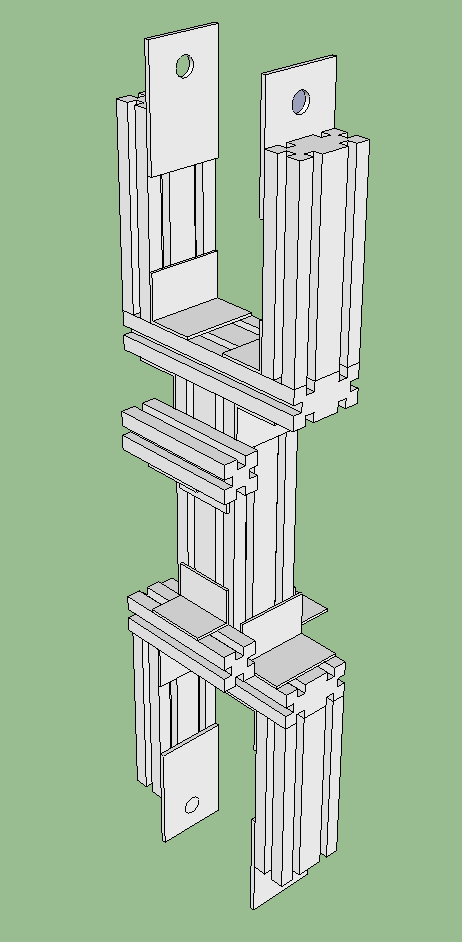
[picture p158: figure]
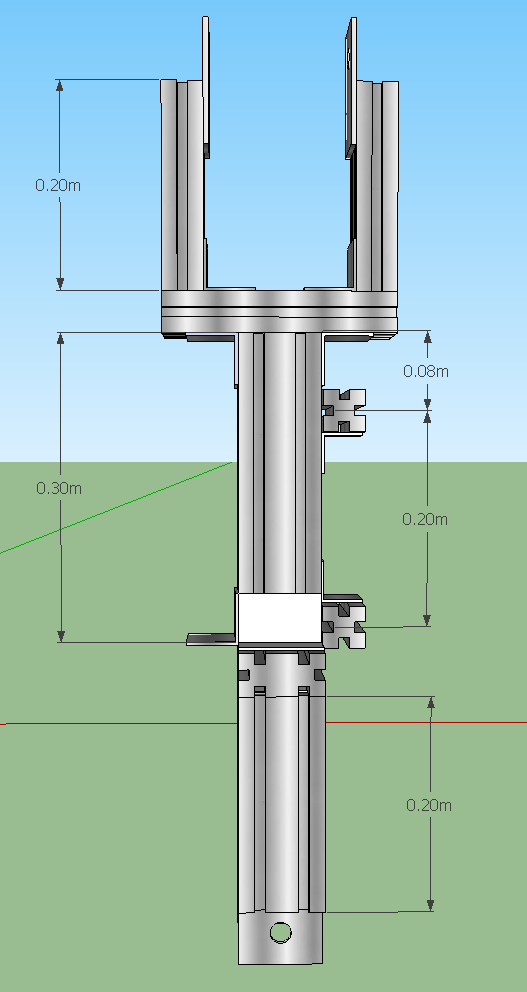
[picture p159: figure]
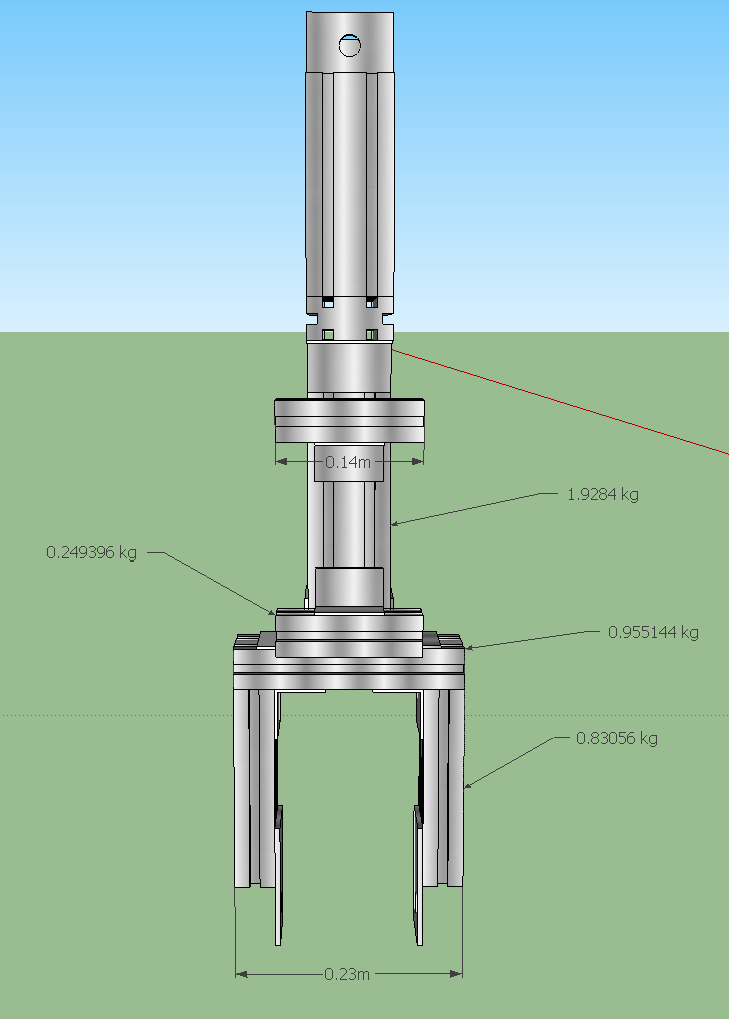
[picture p160: figure]

legs – 20cm

Base – 23cm

column – 30cm

Motor controller base – 14cm
