ruffsl/ROBO/Devices/Bill of Materials - Sheet1.pdf

Electrical

NI cRIO-9024

Real-Time
Controller: 800
MHz, 512 MB
DRAM, 4 GB
Storage | 1242 | 1 | http://www.ni.com/

http://sine.ni.
com/nips/cds/view/p/lang/en/nid/207371 N/A

NI cRIO-9111

4-slot
reconfigurable
embedded chassis
that accepts any
CompactRIO I/O
module | 899.1 | 1 | http://www.ni.com/

http://sine.ni.
com/nips/cds/view/p/lang/en/nid/206762 N/A

NI 9870

Includes 10P10C-DE9 Cables (x4)
For interfacing with
sensors and
controlers | 596 | 1 | http://www.ni.com/

http://sine.ni.
com/nips/cds/view/p/lang/en/nid/204259 N/A

Microstrain 3DM-GX3® -45

3 Axis Gyroscope,
3 Axis
Accelorometer,
GPS | 3795 | 1

http://www.
microstrain.com/

http://www.
microstrain.
com/inertial/3dmgx3-45#?tab=buy N/A

RoboteQ HBL2350

Roboteq’s is a
high-current, dual
channel controller
for the hall-sensor
equipped
brushless
hubmotors | 625 | 1

http://www.
roboteq.com/

http://roboteq.
com/brushless-dcmotorcontrollers/hbl2350-dual-75a-brushless-dc-motor-controller-with-encoder-hall-inputs

http://www.
robotmarketplace.
com/products/RTQ-HBL2350.html

ZyXEL WiFi
Router

ZyXEL Wireless N
Pocket Travel
Router and Access
Point (MWR102) | 24.71 | 1

http://www.zyxel.
com/

http://www.
amazon.
com/ZyXEL-Wireless-Pocket-Travel-MWR102/dp/B005WKIKA0/ref=sr_1_fkmr0_1?ie=UTF8&qid=1365690488&sr=8-1-fkmr0&keywords=ZyXEL+MWR102+USB+Powered+Travel+Router+IEEE+802.3%2F3u%2C+IEEE+802.11b%2Fg%2Fn

http://www.
newegg.
com/Product/Product.aspx?Item=N82E16833181165

Emergency Stop
Switch w/ Key

For emergency
| and lock security | 69.95 | 1

http://www.ia.
omron.com/

http://www.digikey.
com/productsearch/en?
mpart=A22E-MK-02&vendor=236

http://www.omronap.co.
in/product_info/A22E/index.asp
Yellow E-stop box | To mount E-stop | 33.43 | 1

http://www.ia.
omron.com/

http://www.digikey.
com/catalog/en/partgroup/accessories-hardware-tools-and-mounting/36142
Part | Description | Price | Quantity | OEM | URL 1 | URL 2

8040.35

Use torque control setting

Verry Handy for rapid testing and live feeds

Key may be more trouble that it's worth

Note

Tether Emergency
Kill Stop | For user kill cord | 9 | 1

http://www.
aliexpress.
com/item/ATV-Motorcycle-Motorbike-Normally-Opened-Break-Tether-Emergency-Kill-Stop-Engine-Switch-Push-Button-Freeshipping/661083751.html
2.1mm ID, 5.5mm
OD Male Power
Barrel | For IMU | 6.67 | 1

http://www.
switchcraft.com/

http://www.digikey.
com/productdetail/en/767KS12/SC1387-ND/2238430

12V DC/DC
converter | For IMU | 80 | 1

http://www.cui.
com/

http://www.digikey.
com/productdetail/en/PTK25-
D24-S12-T/102-
1161-ND/572990
Solid State Relay | For E-stop | 120 | 1

http://www.crydom.
com/en/

http://www.digikey.
com/scripts/DkSearch/dksus.dll?vendor=0&keywords=LVD75D80&stock=1

http://www.crydom.
com/en/Products/Catalog/l_vd.pdf

Distribution Block

For VCC and VDD
rails | 29.99 | 2

http://www.
streetwires.com/

http://www.
crutchfield.com/S-IwuSVG90PEU/p_211DBX3434/StreetWires-DBX3434.html

http://www.
streetwires.
com/products/default.aspx?grp=62

Hubmotor

36V 500W
Hubmotor 16x2.
125 Front Tire
Fork Size 96mm
Speed 320+-15
RPM | 190 | 2

http://www.
aoduomotor.com/

http://www.
aoduomotor.
com/products.asp?
ClassID=54

Resettable Circuit
Breaker | 70 Amps | 29.99 | 1

http://www.
cooperindustries.
com

http://www.
powerwerx.
com/fuses-circuitprotection/resettable-circuit-breaker-cooper-bussmann.html N/A

Charger

1.25 amp battery
chargers to fully
charge a battery
and maintain a
proper storage
voltage | 85.99 | 1

http://www.
powerwerx.
com/batterieschargers/2-bankinternationalcharger.html

http://www.
amazon.
com/Battery-Tender-022-0165-
DL-WH-12-Volt-Management/dp/B000NCOKV0/ref=sr_1_2?s=automotive&ie=UTF8&qid=1368383606&sr=1-2&keywords=2+bank+charger

Had to swap to Normally Closed

Would get a shorter barrel length

To protect IMU investment from unregulated power rial

Would recomend a trigger voltage lower than 24v with current setup

Great for large gauge cable

Tysonic
Rechargeable
Battery

Tysonic Non-Spillable Sealed
Lead Acid
(SLA/AGM)
Rechargeable
Battery 12V, 7.5
Ahr, Terminal
Type: F2) | 21.99 | 2

http://www.
batteryonestop.
com/baotongusa/index.htm

http://www.
powerwerx.
com/batterieschargers/sealedlead-acidabsorbent-glassmat-battery.html N/A

Frame
Components
80x80mm
aluminum
extrusion | center column | 18.9 | 1

http://www.8020.
net/

http://download.
8020.
net/2012_Product_Catalog/Metric_8020_Catalog_18.pdf 40x80mm
aluminum
extrusion | junction joints | 6.72 | 2

http://www.8020.
net/

http://download.
8020.
net/2012_Product_Catalog/Metric_8020_Catalog_18.pdf 40x80mm
aluminum
extrusion | forks | 16.8 | 4

http://www.8020.
net/

http://download.
8020.
net/2012_Product_Catalog/Metric_8020_Catalog_18.pdf
extrusion end caps | caps | 1.6 | 8

http://www.8020.
net/

http://download.
8020.
net/2012_Product_Catalog/Metric_8020_Catalog_18.pdf

machining

labor for
machinging by 80-
20 | 87.1

http://www.8020.
net/

http://download.
8020.
net/2012_Product_Catalog/Metric_8020_Catalog_18.pdf

self taping cap
screws

screw in the end
caps | 0.28 | 16

http://www.8020.
net/

http://download.
8020.
net/2012_Product_Catalog/Metric_8020_Catalog_18.pdf

end fasteners

attach joints to
column | 1.65 | 8

http://www.8020.
net/

http://download.
8020.
net/2012_Product_Catalog/Metric_8020_Catalog_18.pdf

anchor fastener

attach components
to frame | 3.25 | 8

http://www.8020.
net/

http://download.
8020.
net/2012_Product_Catalog/Metric_8020_Catalog_18.pdf

roll in T-nut - M4

attach components
to frame | 1.6 | 10

http://www.8020.
net/

http://download.
8020.
net/2012_Product_Catalog/Metric_8020_Catalog_18.pdf

roll in T-nut - M5

attach components
to frame | 1.6 | 6

http://www.8020.
net/

http://download.
8020.
net/2012_Product_Catalog/Metric_8020_Catalog_18.pdf

roll in T-nut - M6

attach components
to frame | 1.6 | 12

http://www.8020.
net/

http://download.
8020.
net/2012_Product_Catalog/Metric_8020_Catalog_18.pdf part#: 40-8080 -cut to 300mm

part#: 40-4080 -cut to 160mm

part#: 40-4080 -cut to 400mm

part# 40-2045
this was required to use official 80-20 parts

part# 40-3267

part# 40-3891

part# 40-3897

part# 13027

part# 13028

part# 13031

bolt assortment

attach components
to frame | 12.46 | 1 | Titan

http://www.
amazon.
com/Titan-45307-
Metric-Socket-Assortment/dp/B009TC97EA/ref=sr_1_4?s=hi&ie=UTF8&qid=1365777184&sr=1-4&keywords=metric+socket+cap+screw+assortment

Industrial Strength
Velcro - White

attach components
to frame and other
components | 27.97 | 1 | Velcro

http://www.lowes.
com/ProductDisplay?partNumber=20048-388-90198&langId=-1&storeId=10151&productId=1057497&catalogId=10051&cmRelshp=req&rel=nofollow&cId=PDIO1 purchased through amazon from Tool Liquidators part# Titan 45307

purchased from lowes part# 20048-90198
