ruffsl/ROBO/Documentation/Online Docs/Parts List.xlsx

Types | Product/Name | Price | Quantity | Requirement | Note | URL
Prossesing | NI cRIO-9082 RT | 7999 | 1 | Real-Time Acquisition; High precision; High speed, For NI Showcase | Supplied by NI | http://sine.ni.com/nips/cds/view/p/lang/en/nid/210001
Prossesing | NI 9870: includes 10P10C-DE9 Cables (x4) | 596 | 1 | For interfacing with sensors and controlers | Supplied by NI | http://sine.ni.com/nips/cds/view/p/lang/en/nid/204259
Hardware | 16 inch alloy e-bike hub motor |  | 1 | Platform drive and support | Main Hub Motor/Wheel | http://www.alibaba.com/product-gs/236035747/waterproof_16inch_alloy_e_bike_hub.html
Hardware | MBL1650: 120A NxtGen | 335 | 1 | Control drive wheel motor | DC Brushless Motor Controller | http://www.roboteq.com/brushless-dc-motor-controllers/hbl2350-dual-75a-brushless-dc-motor-controller-with-encoder-hall-inputs
Power | Battery | 41.39 | 2 | Power mobile system |  | http://www.power-sonic.com/images/powersonic/sla_batteries/ps_psg_series/12volt/PS-12100_11_Feb_21.pdf | http://www.atbatt.com/product/3587/sla/power-sonic/ps-12100/battery
Power | Power Regulator |  | 1 | Regulate terminal voltage for sensitive electronics | Dependent on cRIO | http://www.vicorpower.com/
Sensors | 3DM-GX3® -45 (3 Axis Gyroscope) (3 Axis Accelorometer) (GPS) | 3795 | 1 | For system correction input | All in one IMU/GPS, access to 25% Educational discount ($2846.25) | http://www.microstrain.com/inertial/3dm-gx3-45#?tab=buy
 | TOTAL | 12766.39
Hub Motors
http://www.alibaba.com/product-gs/300163758/brushless_hub_motor.html
http://www.alibaba.com/product-gs/518023271/16_500W_scooter_hub_motor.html
http://www.alibaba.com/product-gs/236035747/waterproof_16inch_alloy_e_bike_hub.html
http://www.alibaba.com/product-gs/266998887/48v_500w_brushless_hub_motor.html
Elecrical | Resettable Circuit Breaker Cooper Bussmann | 29.99 | 1 | Fail safe for motor controlers | spec'ed for 70A | http://www.powerwerx.com/fuses-circuit-protection/resettable-circuit-breaker-cooper-bussmann.html
Elecrical | SB120 Loose Piece Colored Housing | 4 | 2 | For battery terminals | spec'ed for 120A, first available over 70A. One read, one blue | http://www.powerwerx.com/anderson-powerpoles/housings-contacts/sb120-loose-piece-colored-housing.html
