ruffsl/ROBO/Documentation/Online Docs/Bookmarks.xlsx

Name | Tittle | Discription | Link | Useful (5/5)
Ruffin's
 | Overview of the LabVIEW Robotics Simulator | Sums up most of the sim and gives a tutoral | http://www.ni.com/white-paper/14133/en#toc1 | 5
 | LabVIEW 2012 Robotics Module Help | All the Robotic help pages in one spot | http://zone.ni.com/reference/en-XX/help/372983C-01/ | 5
 | How send electrical signal through spinning shaft | A good description of the connectors we'll need | http://answers.google.com/answers/threadview/id/705769.html | 5
 | Kamman Final Project | huge pdf of inverted pendulems | http://homepages.wmich.edu/~kamman/IP_FINAL_PROJECT_REPORT.pdf
 | CompactRIO Hands-On Tutorial- Basics I | An older tutorial for the cRIO | http://www.ni.com/white-paper/3111/en | 3
 | NI Motors | Small NI intro to motors | http://www.ni.com/white-paper/8223/en | 2
 | NI Encoders | Small NI intro to encoders | http://www.ni.com/white-paper/3321/en | 2
 | UEA slip rings | for power aplications | http://www.uea-inc.com/products/slip-rings/sizes-and-samples
Kevin's
Spencer's
Ander's
