ruffsl/ROBO/Code/LabVIEW/Simulation/UniCyRO Environment SimulatorRSC4/stl/Traffic Scene.stl

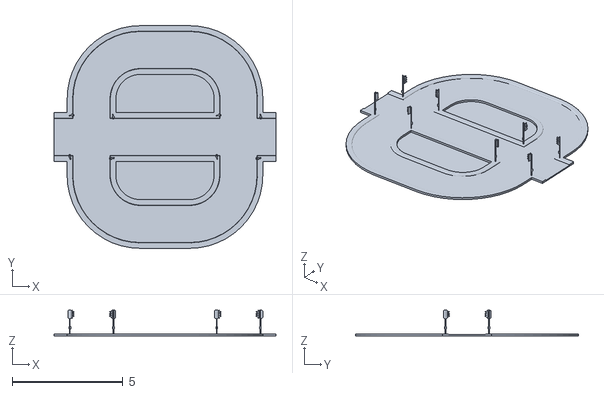
[picture p161: CAD file, 2012-10-11]
Code/LabVIEW/Simulation/UniCyRO Environment SimulatorRSC4/stl/Traffic Scene.stl
10.0 x 10.1 x 1.16
