ruffsl/ROBO/(list of files, cad)

Other CAD files:
Documentation/Design Documents/Drawings/componentPlacement.dwg
Documentation/Design Documents/Drawings/wiringDiagram2.dwg
Documentation/Design Documents/Drawings/frame dimensions.dwg
Documentation/Design Documents/Drawings/wireDetails.dwg
Documentation/Design Documents/Drawings/wiringDiagram.dwg
Model/Components/Aoduo Hubmotor.skp
Model/Components/FinalDesign1.skp
Model/Components/FinalDesign2.skp
Model/Components/FinalDesign3.skp
Model/Components/NI cRIO.skp
Model/Components/Robot Detailed.skp
Model/Components/RoboteQ HBL2350.skp
Model/Components/RobotteQ MDC2250.skp
Model/Components/Tysonic SLA Battery.skp
Model/Components/centerColumn.skp
Model/Sim Model 1.skp
Model/Sim Model 2.skp
Model/Sim Model 3 Labeled 2.skp
Model/Sim Model 3 Labeled 3.skp
Model/Sim Model 3 Labeled 4.skp
Model/Sim Model 3 Labeled 5.skp
Model/Sim Model 3 Labeled.skp
Model/Sim Model 3.skp
