ruffsl/ROBO/Documentation/Online Docs/Final Report - Spring Quarter/User Manual.docx

cover page

preface

contents

mechanical modeling

controls

hardware

troubleshooting

parts list

suggestions for improvement

glossary

parts list

hub motors

power converters

relay

circuit breaker

batteries

cRIO

motor controller

IMU

kill switch

pull out kill switch

dc-dc converter

Mechanical Frame:

80-20 T-slotted aluminum extrusion

anchor fasteners

end fasteners
