ruffsl/ROBO/Documentation/Parts/Electical/Hall Effect Wiring.xlsx

Main |  | Ch1 D9 |  |  | Ch2 D9
Signal | Color | Pin | Signal | Color | Pin | Signal | Color
VCC | Grey | 1 | VCC | Grey | 1 | VCC | Grey
GND | Purple | 2 | A1 | Orange | 2 | A2 | Blue
 |  | 3 | B1 | Red | 3 | B2 | Green
A1 | Orange | 4 | C1 | Brown | 4 | C2 | Yellow
B1 | Red | 5 | GND | Purple | 5 | GND | Purple
C1 | Brown
A2 | Blue
B2 | Green | Ch1 Motor |  |  | Ch2 Motor
C2 | Yellow
 |  | Phase | Pin | Conector | Phase | Pin | Conector
 |  | Yellow | 2 | White | Yellow | 2 | White
 |  | Green | 3 | Blue | Green | 3 | Red
 |  | Blue | 4 | Black | Blue | 4 | Black
