ruffsl/ROBO/Documentation/Design Documents/Drawings/frameDimensions.pdf

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

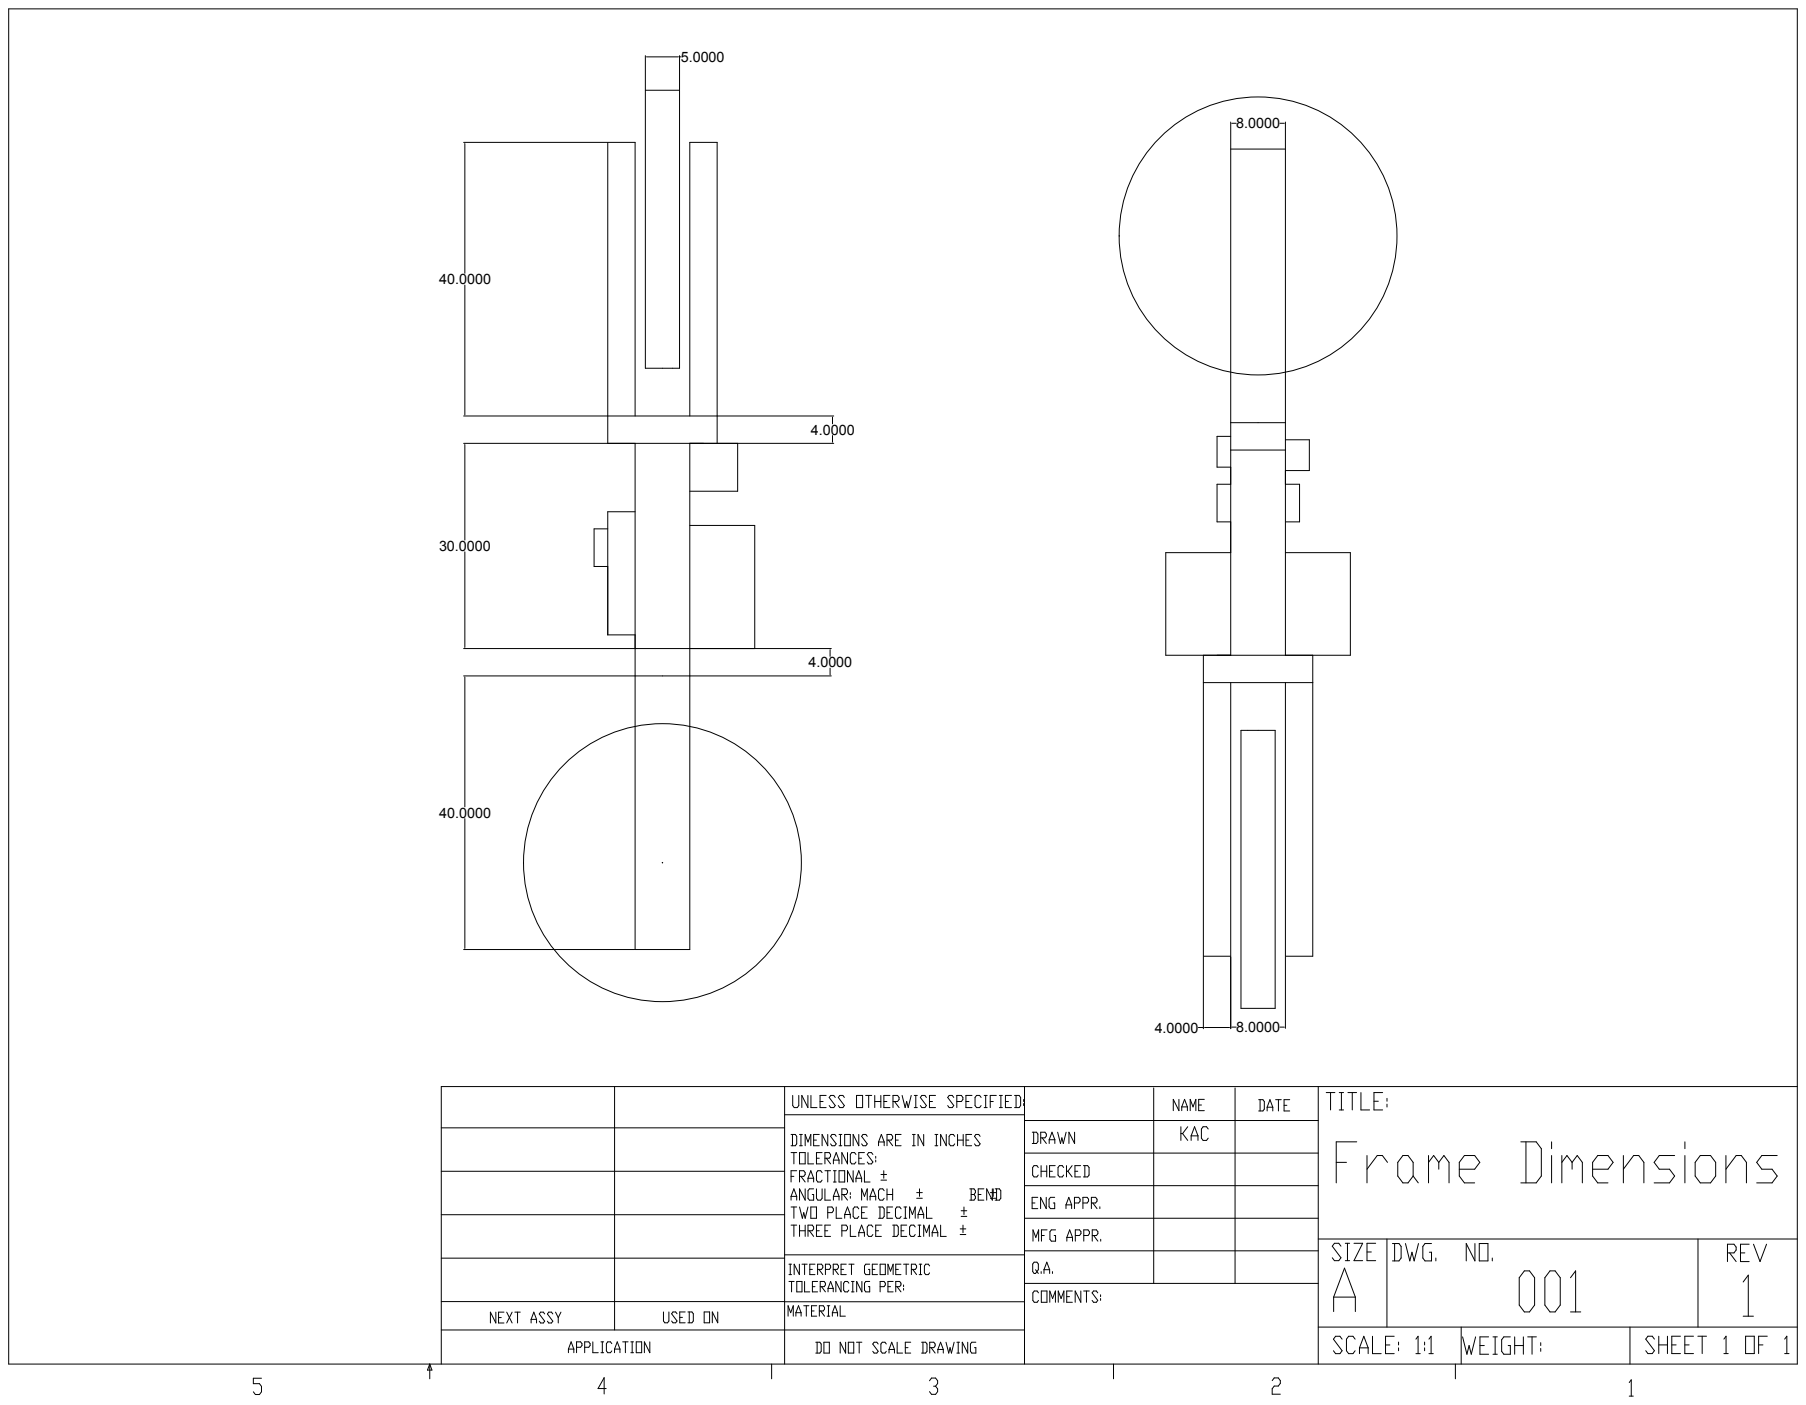
[picture p162: page 1]
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
