ruffsl/ROBO/Documentation/Design Documents/Drawings/wireDetailsDrawing.pdf

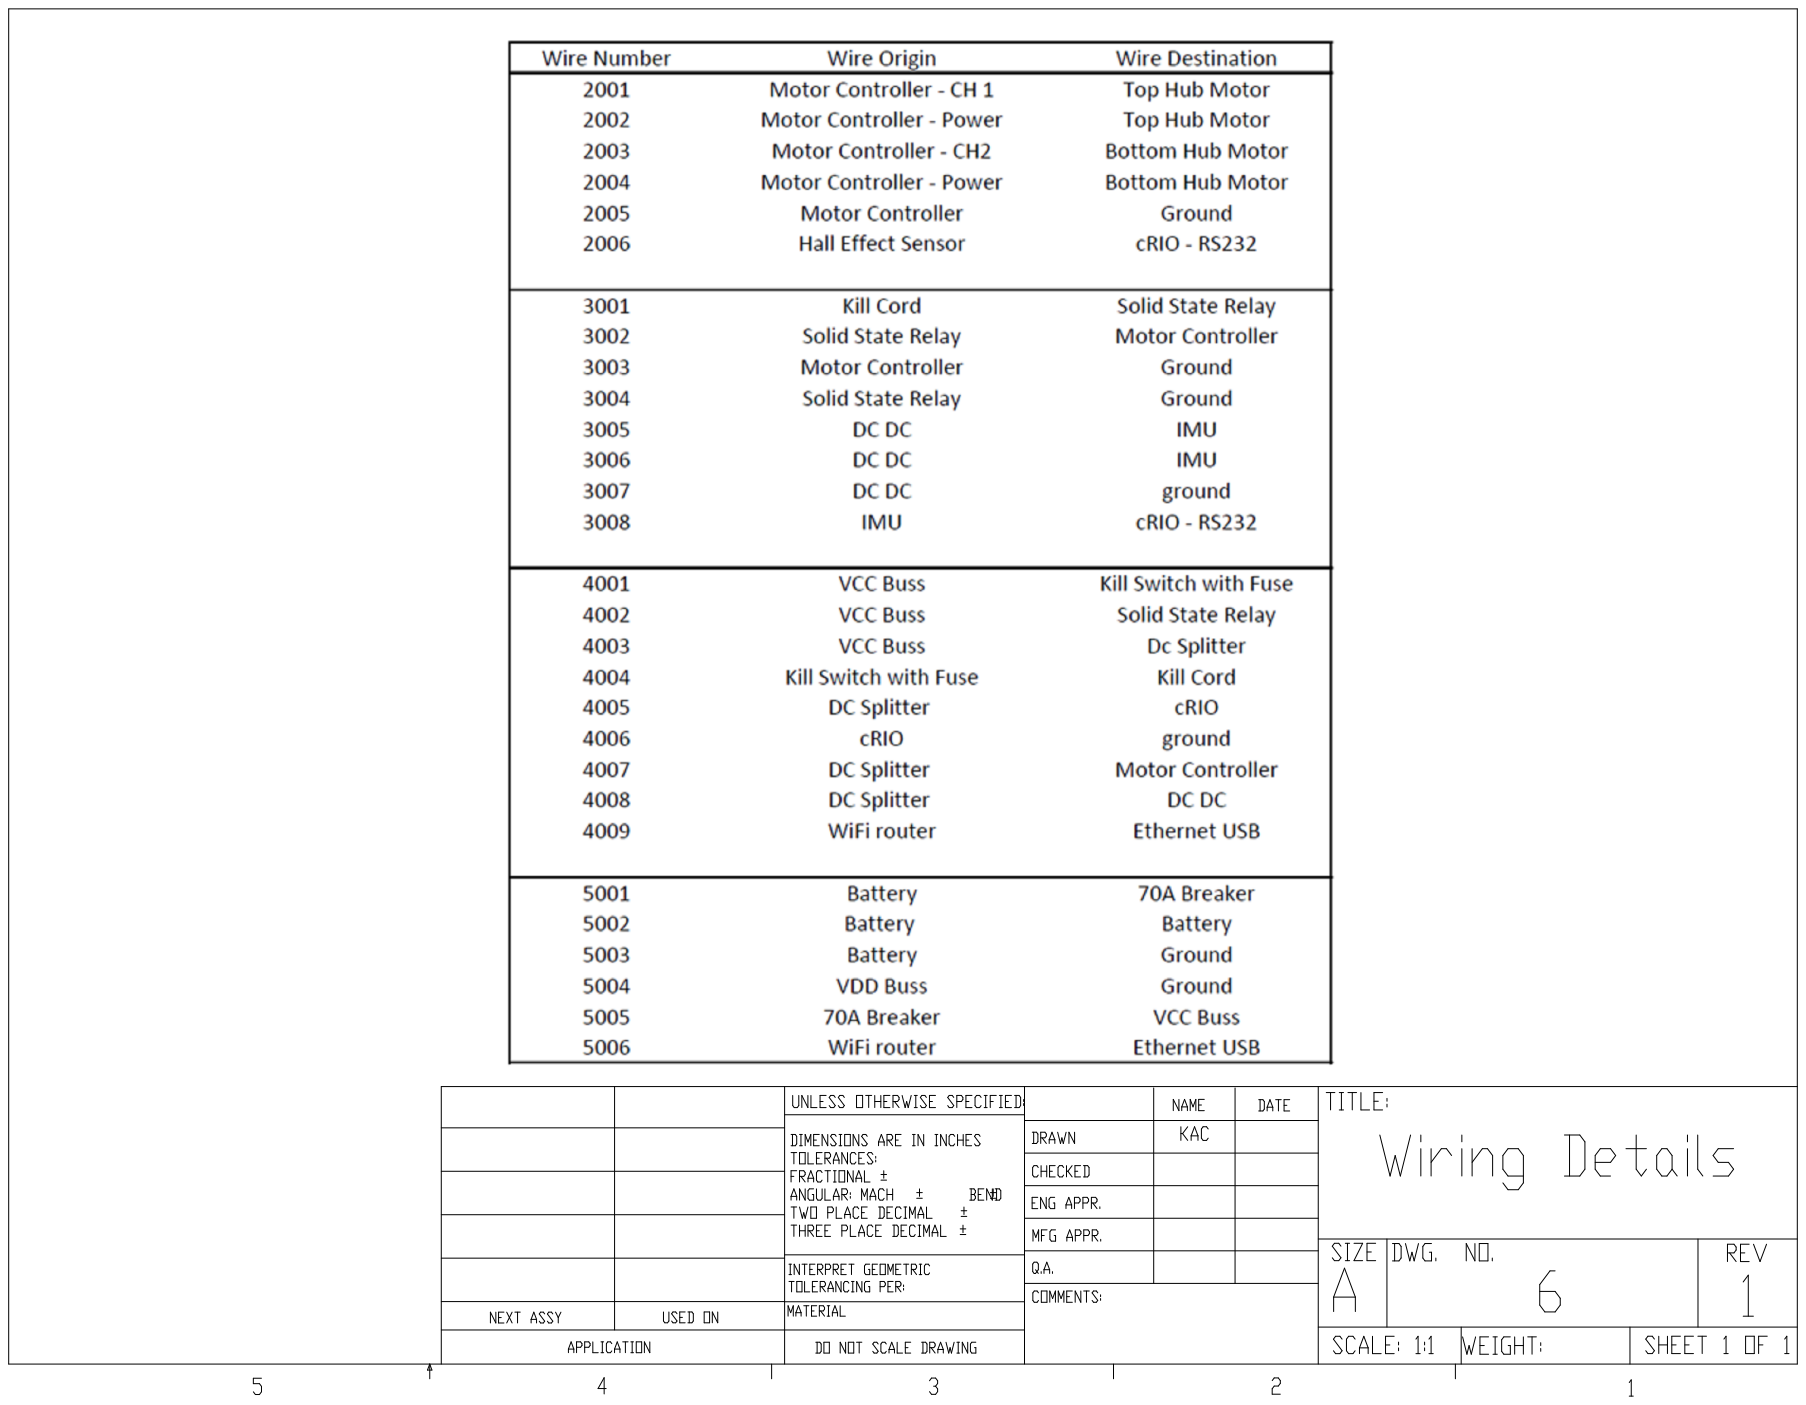
[picture p163: page 1]
