ruffsl/ROBO/Documentation/Design Documents/Drawings/wiringDiagram.pdf

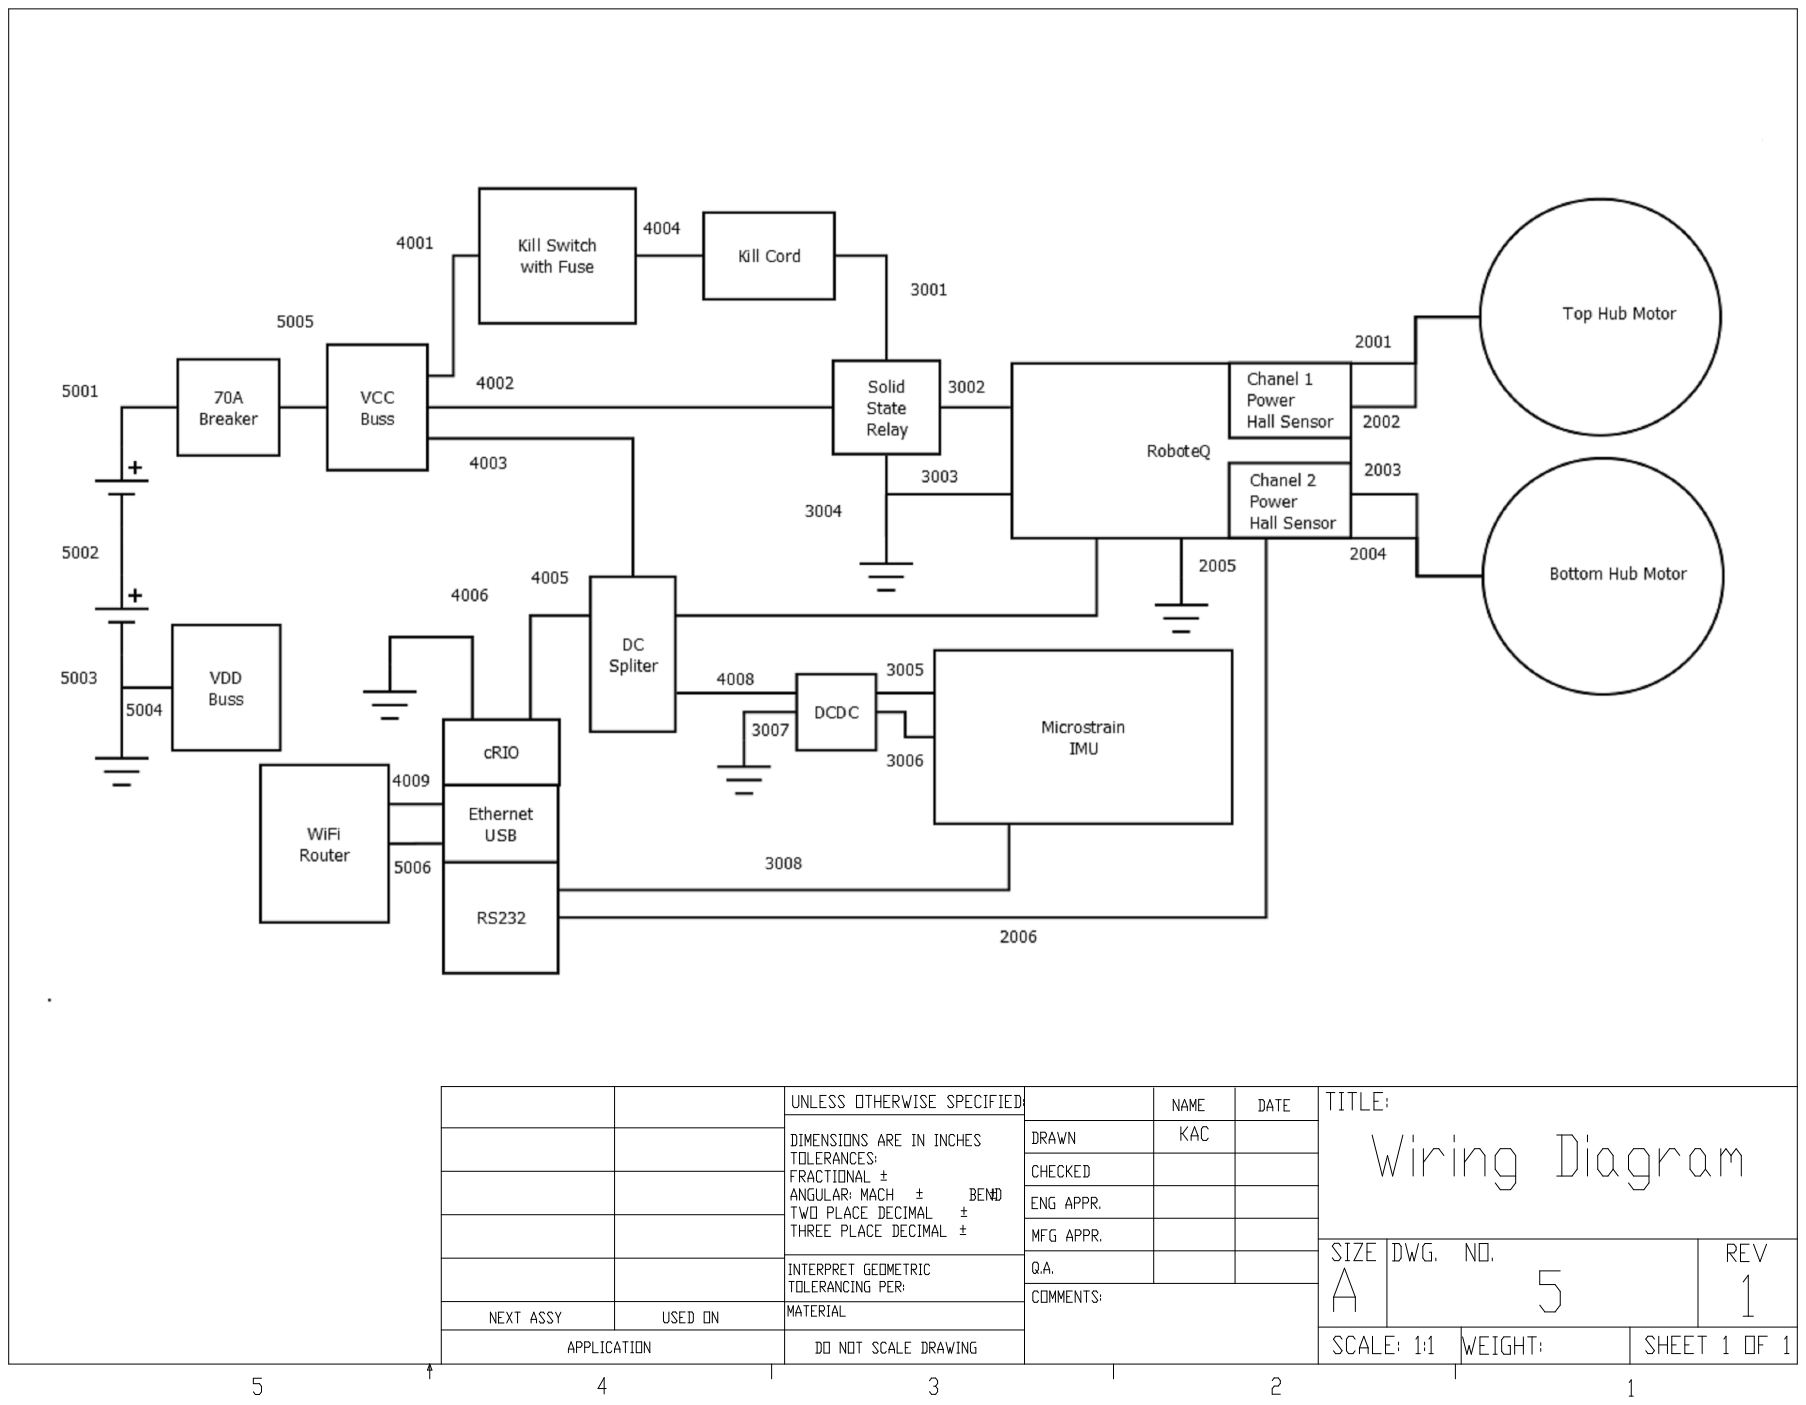
[picture p164: page 1]
