ruffsl/ROBO/(commit log)

2012-10-11 Added sim model from sketchup
    [Sim Model 1.skp]
2012-10-11 MODEL WOOOOO
    Just made a few models of the unicycle, the 4th has mass, joints,
    motors, ansd sensors! The 5th is a simplified version to get the
    inverted base controls working
    [Sim Model 2.skp, Sim Model 3.skp, Traffic Scene.stl]
2012-10-16 Added documentation and powerpoints
    [Sim Model 3 Labeled.skp]
2012-10-17 Added pics to my ppt
    [Sim Model 3 Labeled 2.skp, Sim Model 3 Labeled 3.skp, Sim Model 3 Labeled 4.skp]
2012-10-17 Comic 5 added
    [Sim Model 3 Labeled 5.skp]
2012-10-17 Fix some other power point issues.
2012-10-19 Sim Project Work
    Finished motor initialation setup in simulation
2012-10-20 Sim Project Work
    Added initialize sensors
2012-10-30 Sim Project Work
    Made new working sim
    Need to find out how to set the PID points for the simulated motors
    [Traffic Scene.stl, UniCyRO_Sim.xml]
2012-10-31 Sim Project Work
    Sensors intagrated, compass sensor is broken, and TI simulated motor
    controlers have broken motor movment as they are to week
2012-11-03 Sim Project Work
    Fixed motors and added the abilaty to change max fource for motors
2012-11-07 Sim Project Work
    Added new sim VI for Demo testing, using simple PID for balance, found
    out the NI motor VIs are using PIDs for the motor effort, make it hard
    to empliment a second control method. now joint speeds directly.
    [UniCyRO_Sim.xml]
2012-11-28 Sorted Folders
    Moved the realtime demo projects to its own folder and added a device
    folder for roboteq info.
2012-12-05 Sim Project Work
    Making detailed robot components
    [Aoduo Hubmotor.skp, NI cRIO.skp, Robot Detailed.skp, RoboteQ HBL2350.skp, RobotteQ MDC2250.skp, Tysonic SLA Battery.skp]
2012-12-05 Sim Project Work
    Added detailed robot model, still needs assembly
    [Robot Detailed.skp]
2012-12-10 Finished Preliminary Final Design
    [FinalDesign1.skp, Robot Detailed.skp, centerColumn.skp]
2012-12-11 Slight edit in final design
    [FinalDesign1.skp]
2012-12-11 Updated Chasis Documentation
    [FinalDesign1.skp]
2012-12-16 Sim Project
    Worked on porting modle to simulation
    [FinalDesign2.skp]
2012-12-19 ROBO Control Scheme
    Created a state-variable feedback simulation loop in DT. Added pdf of
    PID controls and Space State strategies in LabVIEW.
2012-12-19 Real Time Project
    Working on custom microstrain drivers
2012-12-19 ROBO Control Scheme
    Wired up the simulation loop for a state-variable feedback system in
    discrete-time. I made teh gain vectors take the vectors from the created
    space model.
2012-12-19 IMU Test project added
2012-12-19 Real Time Project
    Added code to continuously read the microstrain IMU
2013-01-10 Part Doc
    Added documentation for wiring motors
    [Hall Effect Wiring.xlsx]
2013-01-28 Demo Project
    Working on demo code and drivers for IMU and RoboteQ devices
2013-02-06 updated several files
    [FinalDesign3.skp]
2013-02-08 Poster Expo
    Made some additions to the poster
    CONCERNS:
    1. Text is not the right size when printed (transfer to publisher)
    2. No easy-to-understand flow and NO PROBLEM DESCRIPTION!!!!
    3. Lacks engineering data (graphs of IMU data, steady-state PID)
2013-02-12 Part Doc
    added to power diagram
2013-02-12 Added cRIO Motor Control Demo
2013-02-13 Devices
    Added roboteq Firmware update
2013-02-13 IMU + Serial Demo through cRIO
2013-03-16 Controls NonLinear
    Added new tabs to the GUI (Open Loop) and modified the Objective Tab.
    For deployment need to do the following:
    1. Convert the UniPend Nonlinear Model to a static reference VI and use
    it in the Linearizer VI.
    2. Check the coupling between variable names, VIs, state names, local
    variables, etc.
    3. Deploy to cRIO.
2013-03-22 Model added to cRio Motor Demo
2013-03-22 PID added as a control option and restructure
2013-03-26 Control Project
    The Linear Balance and PID Controller now work on the simulated visual.
2013-04-17 Final Code
    Tuned PID a bit
2013-04-21 Final Code
    Updated the IP for wireless
2013-05-08 Doc
    Added schematic
2013-05-09 my personal files
    probably should have added these a while ago. most of them are my own
    calculation scripts and such.
    [bolts list.xlsx, componentPlacement.dwg, frame dimensions.dwg, gant chart.xlsx, values.xlsx]
2013-05-10 lots of work on diagrams
    [wireDetails.dwg, wireDetails.xlsx, wiringDiagram.dwg, wiringDiagram2.dwg]
2013-05-12 updated presentation
    [componentPlacement.dwg, wiringDiagram2.dwg]
2013-05-13 slide framework up
2013-05-18 Added Final Code
    with user manual and google docs
    [Bill of Materials.xlsx, Bookmarks.xlsx, Ghant Chart.xlsx, Parts List.xlsx]
2013-05-31 Cleaning
    Just organized and cleaned up the repo for submission.
    [Bill of Materials.ods, Bill of Materials.xlsx]
